pulsefoundry/Aster-MCA-Nano/firmware/at32-burst/README.txt

Aster MCA Nano AT32 — v0.5.0 分段采集测试固件
状态：v0.5.0 已烧入实物，程序/页边界/选项字节读回校验通过。
SMA空载及探头本底均已完成桌面GUI各30秒验证，采集完整性检查通过。
软件检查：7项分段协议/处理/中断测试、17项上位机回归测试通过；
打包后的1M与分段处理库自检通过，JavaScript语法检查通过。

目的
将 4 MS/s 的 ADC/DMA 采样与波形筛选、USB 传输分开，先验证真实波形。
每次命令采 8192 点（2.048 ms，16 KiB），一次性 DMA 不循环覆盖；
完成中断先停止定时器，再记录错误。停止采样后统计并发送完整原始数据。
不在采样期间筛选、压缩或上传波形。USB 控制/SOF 中断仍运行，
因此并不声称采样期间电气上完全没有 USB 活动。

配置
AT32F423CCT7，Flash 256 KiB，SRAM 48 KiB，擦除页 2 KiB。
CPU 144 MHz，内部 LDO 1.3 V，ADC 72 MHz、12 位、2.5 周期采样。
TMR3 每 36 个时钟触发 PA0 ADC1_IN0；DMA1 Channel1 存储8192点。
沿用实物已用的 XTEST=9 后启用/校准流程、USB 48 MHz HICK/ACC路径。
PB12 心跳灯；PA9 保持输入。无硬件改动，无150MHz升频。
DMA完成中断放在 SRAM 执行，减少最后一次转换后的停表延迟。

主机
capture.py 的 --seconds 表示总耗时，并非实际采样覆盖时长。
每段独立验证序号、长度、CRC32、极值、和、平方和、DMA错误、剩余数、
ADC溢出及起停周期数。原始串口字节保存在 wire.bin，便于审计错误帧。
samples.u16 为各段顺序存储；必须按 blocks.jsonl 的边界读取。
段间没有样本，不能把前后段拼成连续波形。
events.csv 用 segment_id、trigger_sample_in_segment 和 time_in_segment_s
标识事件；stored_sample_offset 只用于定位文件，不代表连续时间。

上位机处理
保留已有4M主机算法：256点基线+16点保护区，负脉冲门限默认20码，
64点事件窗，峰高及4/8/16微秒积分。每段完全重置处理状态。
前272点用于基线建立；末59个位置无法提供完整事件后沿。
截断的待处理事件丢弃，计入 boundary_partial_events_excluded。
analysis_window_seconds 只扣这些几何边界，不等于经过死时间修正的活时间。
段内触发保持、堆积与质量筛选仍影响接受率；未能量标定。
分段模式与原1M/4M连续记录使用不同method，GUI禁止直接扣本底。

桌面界面
outputs/Aster Nano.app 同时支持原1M v0.3.1、4M选窗v0.4.4、分段v0.5.0。
分段模式显示总耗时、实际采样覆盖时长和采样占比。
选定的门限仅用于电脑端分析，降低门限不会增加板端数据流量。
停止按钮等待当前完整段收完再停止。错误或中断记录标记无效并禁用导出。

烧录边界
flash.py 默认仅接受当前实物 v0.4.3 的精确二进制匹配。
先备份全Flash和选项字节；只按程序所需页擦写；读回确认程序、页填充、
擦除范围外及选项字节。--restore-1m 仅从精确 v0.5.0 恢复旧v0.3.1。
需要实体BOOT操作；没有应用内自动进入DFU的功能。

首次实测计划
1. SMA断开：INFO确认版本/时钟/ADC初始化，短时多段传输与耗时检查。
2. 检查每段CRC及所有采集错误为0、无段号跳变、原始点数匹配。
3. 检查基线、噪声、异常跳变；USB间隙单独记账。
4. 用户确认接好已开启探头、源移开后，再测真实负脉冲。
只在上述实测通过后更新本文件状态；编译/单元测试不代替实物验证。

2026-10-15 实物空载结果
桌面GUI总耗时30.029601秒，共1081段、8855552点；每段8192点。
实际采样覆盖2.213888秒，采样占比7.372%；其余为USB/主机处理等空档。
CRC/统计/段号/时序检查全部通过，DMA错误、DMA剩余数、ADC溢出均为0。
每段起停耗时295034–295039个144MHz周期，约2.04885ms，含起停开销。
段内标准差中位数1.969 ADC码，范围1.663–2.674码；基线均值2050.016–2051.753码。
20码主机门限下候选0，接受0。只说明该空载短时记录，不能推导能量分辨率。
数据：work/at32-gui-recordings/capture-20261015-001021-516284
首次1秒测试：work/at32-burst-2026-10-14/open-input-first（36段，全部通过）。
桌面应用已实测连接v0.5.0、启动采集、显示采样覆盖/总耗时/采样占比并自动保存。

2026-10-15 探头本底结果
用户确认探头接好并开启，保持原高压/增益，铯源和钍源移开。
GUI总耗时30.030704秒，1081段/8855552点，采样覆盖2.213888秒；占比7.372%。
完整传输及采集检查通过，无DMA/ADC错误。393个完整候选，356个接受。
37个未接受：36个基线未稳定，1个同时标记堆积和过宽/过晚（标记可重叠）。
另有2个段末截断待处理事件排除；段首272点和段末59个触发位置不作为完整事件窗口。
接受事件典型半高宽5–6点（1.25–1.5us），为半高宽而非用户描述的整个脉冲宽度。
接受峰高中位数73.924ADC码；积分中位数118.953 ADC码·us。全记录无0/4095削顶。
已保存波形和本底谱，并在当前桌面会话设为本底。新旧模式不能直接扣本底。
数据：work/at32-gui-recordings/capture-20261015-001338-073683
波形图与统计：本发布文件夹 evidence/probe-background-waveforms.png 及JSON。
后续建议保持设置做铯源对照；7.4%采样占比意味着要增加总测量时间。
截至本检查未做4M分段铯源峰宽测量，不宣称能量分辨率已经改善。
