pulsefoundry/Aster-MCA-Nano/firmware/at32-dma/README.txt

最新状态：v0.2.0 已烧入实物 AT32F423CCT7，并完成采样率与空载验证
更新：2026-10-14T13:55:12.160544+08:00

结论
1 MS/s 定时器触发＋DMA 采样已在实物运行。默认每点间隔 1 us，相比之前 100 kS/s 提高 10 倍。
仍为分段诊断采集，USB 发送期间有间隙，不是连续无死时间 MCA。

烧录证据
- 写入 16180 字节，读回全 Flash 对比成功；末页填充为 FF，擦除范围外保持原样。
- 选项字节前后相同。未改写引导配置。
- SHA256：1ed998aa856a1b4ae0054efbbae88566aaad50e31cf5bf66c41001bb8ce66934。
- 退出 DFU 时工具返回 74；随后同序列号 USB CDC 恢复并返回 v0.2.0，确认应用启动成功。

实物验证
- 10 kS/s、100 kS/s、500 kS/s、1 MS/s 均完成采集和主机独立校验。
- 共 48 段、393216 点，全部 CRC32、极值、总和、平方和一致。
- 所有记录 DMA 错误=0、DMA 剩余数=0、ADC 溢出=0。
- 1 MS/s 每段 8192 点；空载复测起停耗时 393353–393357 个 48 MHz CPU 周期，
  约 8.19485–8.19494 ms。设定采样时长 8.192 ms，差值含转换、开始/完成处理开销。
  这是内部计时的实测佐证，绝对频率尚未使用外部校准时基验证。
- ADC 暂停时拒绝采样；重新初始化后采样正常；不支持的采样率请求被拒绝且原配置保持。
- 软件重启后恢复默认 1 MS/s，USB 恢复，三段原始数据校验通过，ADC 故障码为0。

空载复测（用户明确确认 SMA 完全断开）
- 10 kS/s：8 段，基线约 1.649649 V；标准差 2.296 LSB（约 1.850 mV RMS）。
- 100 kS/s：8 段，基线约 1.649923 V；标准差 2.290 LSB（约 1.845 mV RMS）。
- 1000 kS/s：16 段，基线约 1.650014 V；标准差 2.267 LSB（约 1.826 mV RMS）。

早期异常与限制
刚烧完的第一轮记录有较大的瞬态，不能当成探头脉冲或静态底噪指标。
用户确认 SMA 断开后，ADC ON 重新校准并做32段复测，未再出现相同的大幅异常；
随后软件重启、使用上电初始化路径的三段1 MS/s采样也正常，标准差约2.20–2.25 LSB。
插拔扰动、接触/环境影响与重新校准的作用没有被独立分离，因此不宣称已定位根因。
本轮基线数值只代表这些短记录，不是长期稳定性、ADC本体ENOB或整机能量分辨率。
所有电压按名义3.3 V参考换算，指ADC引脚。输入建立时间、窄脉冲峰值和能谱仍待探头实测。

当前板上状态
v0.2.0，1 MS/s，ADC 开启；无命令时不采样，运行灯心跳继续。
可以接回探头，在新采样率下重新观察负脉冲能否覆盖足够多采样点。

文件
固件 .bin、.elf、manifest.json；source/源码快照；evidence/包含全部烧录、首轮验证、
空载复测、软件重启记录与原始二进制；validation-summary.json为汇总。
以下保留开发阶段记录，其中“等待烧录”状态已经被上面的实物验证更新。

============================================================
Aster MCA Nano AT32 v0.2.0 — 1 MS/s 定时器/DMA 诊断固件
状态：已编译及静态检查；等待用户将实物板进入 BOOT/DFU 后烧录验证。未声称已在实物运行。

变更
- 最高配置从 100 kS/s 软件轮询提高到 1 MS/s 硬件定时触发；每点名义间隔 1 us。
- 保留 10 kS/s、100 kS/s、500 kS/s，支持 RATE 10000/100000/500000/1000000。
- SLOW=10 kS/s；FAST=100 kS/s；TURBO=1 MS/s。上电默认 TURBO。
- 每段 8192 个 12 位 ADC 样本，uint16 小端传输；CPU 在采集完成后统计并发送。
- TMR3 TRGOUT 触发 ADC1_IN0，DMA1 Channel1 经 DMAMUX 从 ADC1 ODT 写入 SRAM。
- 使用一次性 DMA，不循环覆盖；完成中断先停定时器，再记录 DMA 错误、剩余数、ADC 溢出及 DWT 耗时。
- CRC32、样本和、平方和、极值仍由主机独立重算。

时钟与模拟条件
- HICK/ACC、CPU 和 USB 保持已验证的 48 MHz 路径，无外部晶振/PLL 改动。
- ADC 时钟改为 HCLK/2=24 MHz，保留 xtest=9 后启用/校准的厂家勘误修正。
- 1 MS/s：6.5 ADC 周期采样；12 位转换 12.5 周期。
  加上普通组触发延迟 2 ADC 周期和 1 PCLK2 周期，名义合计约 895.8 ns，小于 1 us。
- PA0 属于快速 ADC 通道。设计 R20=100 ohm、C9=1 nF，动态建立时间仍需实测。
- PA0 模拟输入、PB12 低有效运行灯、PA9 输入和 SWD 配置保持。

已做的软件检查
- ARM GCC 14.2 编译通过，无编译告警。
- 固件 16180 字节；按 CCT7 的 256 KiB Flash、2 KiB 页检查边界。
- 链接 SRAM 48 KiB，DMA 缓冲区与预留栈不冲突；DMA 中断向量指向实际处理函数。
- 四档 ADC 转换加触发延迟均小于设定周期。
- 主机拒绝 DMA 错误、未传完、ADC 溢出和整段耗时偏离预期超过 1% 的数据。

烧录和验证
- 用户先断开 SMA，按住 BOOT 重插 USB，约 1 秒后释放。
- flash.py 仅接受唯一的 2E3C:DF11、256 KiB / 2 KiB DFU 设备，先备份 Flash/选项字节。
- 核对旧应用为 v0.1.0 后才写入；读回全 Flash/选项字节，逐字节校验新程序及边界外不变。
- 成功后退出 DFU，再由 verify.py 验证四档采样、CRC、耗时、ADC 暂停/重启和心跳。
- 如 Mac 再次提示配件访问，需要允许。USB 产品名、VID/PID、序列号生成方式沿用 v0.1.0。

范围
这仍是分段诊断采集，USB 传输期间存在采集间隙，不能当作连续无死时间 MCA。
1 MS/s 仍不保证能准确测量亚微秒脉冲；必须先看实测波形能否被足够多采样点覆盖。
当前不支持应用内切换 ROM DFU；后续升级仍需物理 BOOT 操作。

源码及复现
源工程：firmware/at32-dma；同工程 firmware/at32-bringup/read_baseline.py 提供主机传输。
构建脚本依赖本机 ARM GNU 14.2 工具链及 work/at32-bringup-2026-10-14/sdk。
source/ 为源文件快照，不含完整 SDK/工具链，非独立构建目录。
SDK commit a60472b248c39034f111ac17e7b1286549594435。
依据：本地官方 AT32F423 数据手册 Rev 2.03 第68–69页、ES0010 Rev 2.0.5 第8页、厂商定时器/ADC/DMA示例。
