pulsefoundry/Aster-MCA-Nano/firmware/at32-peak-scope/reference/README.txt

Frozen v0.8.1 image retained solely for guarded migration identity checks. Its finite full-buffer RAW diagnostic failed with ADC overflow and is not a recommended firmware. Use the validated v0.8.2 image for the current diagnostic mode.
SHA256: 86ab85df37dd1405018b548fcc33a5acf73e55440f268712b980be2d4259b0cb
