pulsefoundry/Aster-MCA-Nano/docs/2026-10-18-checkpoint.md

# 2026-10-18 检查点

本轮工作已结束，采集停止。用户外出后只进行本机整理、软件检查和 Git 推送；没有继续访问板子、重新烧录或自动采集。

## 需要保留的实物状态

- AT32F423CCT7，AT32 v0.3 PCB。
- 已装 v0.8.2；本次增益改焊没有重新烧固件。
- R21 = 40.2 kΩ，R22 = 10 kΩ，标称运放增益 5.02。用户报告两者串联约 50.2 kΩ，直流节点符合预期。
- 正常采谱门限 100 ADC 码，4 MS/s，2048 道、每道 1 ADC 码。
- 最后确认的探头已开启、接在 SMA，铯源处于此前位置，高压和探头增益保持原设置。这是当时记录，恢复前须重新确认。
- 上位机 v0.6.1 显示改焊后 60 秒铯源谱，叠加改焊后 10 秒本底。重连会回填门限 20，使用当前板子需改回 100。

## 已完成验证

v0.8.2 完整烧录回读、选项字节不变与擦除范围外 Flash 不变检查通过。v0.8.1 的全缓冲 RAW 因 ADC 溢出被否决，v0.8.2 使用半缓冲停止及另一半保护区。

改焊后空载 100 段 RAW + 3 秒谱、探头本底 500 段 RAW + 10 秒谱、铯源 500 段 RAW + 10 秒短测 + 60 秒谱均通过完整性检查，无设备超时或 ADC 溢出。

本底 10.000384 s 接受 898 事件；铯源 10.000384 s 接受 2928 事件；铯源 60.000256 s 接受 17,611 事件。最后一轮 58,594 个 DMA 块全部处理。最晚快照复制结束为 17,220 个 CPU 周期，低于 147,456 周期的覆盖期限。

接探头的安静 16 µs 短窗口噪声约 0.95–0.97 ADC 码 RMS；该统计移除了每窗均值，并有范围筛选，不涵盖全部低频漂移及正常实时处理负载下的噪声。

## 谱与拟合边界

改焊前后各 60 秒谱采用相同整数取峰算法。旧固件为 v0.8.0，新固件为 v0.8.2；门限 20 → 100 近似补偿增益变化，基线质量筛选仍保持固定 ADC 码上限。

| 项目 | 改前 | 改后 |
|---|---:|---:|
| 峰位／ADC 码 | 78.333 | 408.787 |
| FWHM／ADC 码 | 13.471 | 65.695 |
| FWHM／峰位 | 17.197% | 16.071% |

总源谱使用逐道积分高斯加非负线性连续本底，未平滑、未拟合扣本底数据。改后窗口敏感性约 15.36%–16.96%。300 次模型条件下 Poisson 重采样的改后－改前差值 95% 区间为 [−2.50, +0.33] 个百分点，尚未证明显著提升。统计区间不含模型、漂移、源位置复现及模拟／质量筛选系统误差。未作多点能量标定。

当前证据只支持这组配置下的整体表现约 16%，不能直接称为探头本征分辨率。9% 是早前外推值；另一台成品 Aster 曾有约 12% 实测，但不是本轮同步切换的严格对照。

## 后续方向

先确认实体接线和源状态，再决定是否继续。可优先做同一批原始脉冲的采样峰高、峰顶插值、短窗积分对照，并检查漂移与脉冲形状依赖；尚无新的算法改善结论。

原始波形诊断每组 500 × 4096 点仅覆盖 0.512 s，段间存在上传空隙。正式 60 秒谱使用板上连续采样、结束回传的路径，两者时间含义不同。

数据、图和详细验证表见 `outputs/Aster-MCA-Nano-AT32-增益5倍实测-20261018`；改焊位置与料号见 `outputs/Aster-MCA-Nano-AT32-增益改焊-20261018`。
