pulsefoundry/Aster-MCA-Nano/firmware/at32-continuous/README.txt

Aster MCA Nano AT32 连续采样固件 v0.3.1
2026-10-14

目标与当前状态
保持 1 MS/s、12位、PA0输入及现有模拟前端；连续DMA，电脑端处理脉冲和能谱。
新固件已烧入并回读校验；通过空载1秒、60秒连续采集及故意停止读取后的保护/恢复测试。
60秒采集完整保存60,000,256点，所有块校验通过，未报告DMA/ADC/处理超时错误。
探头本底和铯源对照尚待进行；目前只完成空载连续采集验证。

硬件采集
CPU 96 MHz、ADC HCLK/4=24 MHz、采样6.5周期、TMR3每96周期触发，保留XTEST=9。
ADC DMA环4096点，每半2048点，半块间隔2.048 ms。
DMA/USB解耦；6个压缩包缓冲；正常采样期间没有停定时器上传的间隙。
采集到完整半块后压缩，另半块继续采样。压缩前后检测覆盖风险和DMA错误。
缓冲区满、来不及处理、ADC溢出、DMA错误等会停止并报告失败，不静默丢样。
主机停止或定时结束在完整半块边界执行；边界后的少量尾样本单独报告并排除。

无损传输
每个块预测器从0开始。按低半字节先行编码：0..14表示差分-7..+7；
15表示后续三个半字节给出绝对12位样本。最后一个未用高半字节为0。
没有触发筛选、抽点、截位或板上幅度计算，全部样本发送到电脑。
历史空载和放源数据约0.54–0.56 MB/s（含头部），最坏输入仍可能超过USB能力。
缓冲区只能吸收短时抖动，不保证任意高熵波形均能持续无损传输。

协议
ASCII命令（仅空闲时响应）：INFO、PING、STREAM 毫秒、ADC OFF、ADC ON、REBOOT、HELP。
STREAM 0持续运行直到STOP；定时STREAM支持1–3600000 ms，时长向上取整到2048点。
开始响应OK STREAM后仅发送二进制包；采样中仅处理STOP，不混入ASCII应答。
80字节头：8字节ASTC03\r\n + 18个小端uint32：
版本、类型、会话、块序号、首样本位置低/高、样本数、采样率、载荷长度、编码、
解码样本哈希、载荷哈希、错误标志、已完成DMA块数、DMA中断DWT周期、
编码周期、经过毫秒、头部哈希。
类型1为2048点压缩数据；类型2为JSON终止记录。哈希用于传输完整性检查而非安全认证。
载荷/头部用字节FNV-1a；样本用uint16值逐次xor/multiply的32位FNV变体。
如果80+载荷字节数是64倍数，则附加一个0字节，使USB传输以短包结束。
主机拒绝校验失败、错序、重复、样本位置不连续、会话改变及错误终止的记录。
出现异常时标记整轮无效，发送STOP并保存后续诊断字节，再读取空闲状态。
异常字节不重新拼接成有效能谱；电脑暂停读取3秒的实测触发了板端缓冲满及USB超时。

上位机
capture.py保存stream.astc、完整解压samples.u16、blocks.jsonl、events.csv、
spectrum.csv、capture.json、spectrum-summary.json。
全部解压和脉冲处理在Mac本地执行。首次运行由cc编译本地辅助库。
固定基线来自触发前64点，预留4点间隔；负脉冲门限默认20码。
有符号积分窗口4/8/16 us，从触发前一个点开始；所有状态跨DMA/USB边界保持。
事件标记位：1基线不稳，2可分辨堆积，4采样削顶，8过长/过晚，16未恢复。
能量估计保存为原始采样峰高和积分面积，不应用keV标定。
两个4096道直方图：peak=峰高码值取整；area8=8us面积码·us除4后取整。
直方图越界独立计数，不回卷也不伪造满量程道计数。
末尾未完成事件单独排除；触发保持时间及筛选会影响接受率。
1 MS/s仍可能低估窄脉冲峰高；当前不能声称能量分辨率或无堆积。

例：在当前工程根目录运行
python3 firmware/at32-continuous/capture.py \
  --port /dev/cu.usbmodem13819F0C28761 --seconds 30 \
  --input '探头已开启，源已移开；记录实际增益/高压/接线' \
  --out work/at32-continuous-2026-10-14/background-unique-name

构建与检查
python3 firmware/at32-continuous/build.py
python3 firmware/at32-continuous/test_host.py
flash.py仅接受当前已烧入v0.3.0旧固件及256KiB/2KiB页DFU设备。
烧录前备份全Flash和选项字节，写入后校验全Flash及擦除范围外不变。
板上BOOT操作由用户完成；不修改选项字节，不做全片擦除。

输入状态必须随每轮记录
空载、探头关闭、探头开启本底、铯源在位不可混淆。
先固定探头高压/增益/接线和源几何，采背景，再由用户确认放源后采源组。
比较时使用采样覆盖时长归一化，并同时查看筛选、削顶和错误计数。
原始数据与上位机参数保留，以便对同一批脉冲重做算法比较。

修订v0.3.1：v0.3.0实板在48MHz下编码耗时达到约96660周期/半块，触发处理超时保护；该版不能作为有效连续采集版本。优化双样本快速编码并将CPU调至96MHz，保持ADC24MHz和1MS/s。60秒空载实测最大编码38672周期，约0.403ms，发送队列最多占1/6。

空载模拟表现：60秒数据的全记录标准差约3.05mV RMS（按3.3V标称换算）；范围2029–2081码。
默认20码触发门限下出现1536个候选，全部因过长/未恢复而排除，入谱0个。
这不证明模拟噪声消失或对探头无影响。保持原始样本，以探头数据继续验证和调整电脑端算法。
