pulsefoundry/Aster-MCA-Nano/firmware/at32-eventstream/README.txt

Aster MCA Nano AT32 v0.7.1 — 0.5 MB/s 原始波形传输优化候选版
状态：v0.7.1空载30秒吞吐通过，但真实探头事件传输在约54 ms处理超时，不能用于正式采集。用户已决定停止此路线，准备回退v0.6.3。

模式
BENCH <毫秒> <门限>：ADC持续4 MS/s运行并逐块检查，每两个4096点DMA块传前一个块的前512点。
有效原始波形速率为500000 B/s（按标称采样时钟），含帧头/校验约533203 B/s。
这只是带真实ADC负载的固定速率测试；电脑只收到6.25%的采样点，不能作为完整脉冲采集。
STREAM <毫秒> <门限>：连续ADC/DMA，负向触发，传每个候选的512点原始波形。
包含触发前320点（80us）、触发起192点（48us）；触发保持时间64点（16us）。
基线256点、保护16点，门限默认20 ADC码；在电脑端保留基线、脉冲和尾部以便重新整形。
没有板上能量积分、质量筛选或直方图，不能把触发数等同有效谱计数。
每个事件1024字节波形+68字节元数据/校验，约498触发/s时有效0.510 MB/s，总帧0.544 MB/s。
触发稀少时传输量会降低，不用补充虚假事件来凑速率；高计数率可能超过能力。
最长600秒，避免32位绝对采样位置溢出；不可连接窗口之间的空缺。

完整性
独立4096点快照沿用v0.6.3，复制截止时间1.024ms；DMA/ADC/中断/复制超时自动停机。
8帧队列，整帧异步USB传输，数据缓冲在传输完成前不复用；队列满或USB超时停机，禁止静默丢包。
64字节包头、1024字节原始ADC数据、4字节校验尾；短包结尾，顺序和校验均验证。
接收端额外核对触发与所传基线是否一致、重叠波形逐点一致以及结束时计数守恒。
保存wire.bin、windows.u16、windows.jsonl、capture.json；失败记录保留为诊断，不生成有效谱。
已知边界：启动320点不触发；结束不足192点后沿的候选单独记账；保持时间内再次跨门限计数单独报告。
通过数据完整性检查不等于无触发死时间，不等于已标定能谱。

配置
AT32F423CCT7；CPU144MHz，内部LDO1.3V，ADC72MHz/12bit，采样4MS/s；硬件/引脚/时钟均沿用已验证配置。
不改动原v0.6.3固件源码与已保存谱。新固件不兼容旧桌面GUI，只使用本目录接收端验证。
固件内置复制、SIMD、触发自检；故障时拒绝采集。

上板步骤
先断开SMA并用实体BOOT进入DFU，运行本目录flash.py：精确匹配已冻结的v0.7.0、备份全Flash及选项字节，写入后完整读回验证。
先INFO/自检；空载BENCH 3秒再30秒，核对有效吞吐、队列余量及ADC完整性。
空载STREAM检查异常触发；用户重新确认探头及源状态后，测试真实事件传输。
只有实测后才能标记0.5 MB/s成功。若需回退，实体BOOT后flash.py --restore-histogram。

命令示例（端口须重新核对）
python3 firmware/at32-eventstream/capture.py --port <端口> --out <新目录> --seconds 3 --mode bench --condition 'SMA断开'
python3 -m unittest discover -s firmware/at32-eventstream -p test_eventstream.py -v

v0.7.1变化：把事件窗口复制、FNV校验、帧头写入和发送队列管理放到SRAM运行；复用互不重叠的回复/终端缓冲，减少RAM消耗。
门限20、512点窗口、4 MS/s、144 MHz、8帧队列与停止保护保持不变。新增上电4脉冲/1.024ms真实打包自检，含循环复制与校验，USB中断负载仍需上板验证。
ARM汇编已检查：打包热路径均在SRAM，没有对Flash中的memcpy调用。二进制23456字节，静态RAM42816字节，预留4096字节栈后另有2240字节余量。
软件测试包含与独立Python实现逐字节对照的帧编码，以及端到端分片接收测试；均不替代MCU时序实测。
