pulsefoundry/Aster-MCA-Nano/firmware/at32-histogram/README.txt

Aster MCA Nano AT32 — 板上2048道 v0.6.3
状态：2026-10-16已烧录，读回、自检、3秒空载及30秒探头本底均通过。
探头本底：采样30.000128s，含回传校验30.015168s，覆盖99.950%；通过筛选5461、谱内5460、低端量程外1。
最忙计算243001周期（1.687507ms），复制最晚104389周期（0.724924ms），期限147456周期；无ADC/DMA错误。
仅验证这一轮30秒本底；放源负载、长时间稳定性、能量标定与死时间校正仍待验证。
12项算法/通信测试、19项GUI回归测试通过。

v0.6.2在接探头2.109秒后发生复制超时。其编译产物调用Flash里的nano-libc memcpy，8KiB复制约50764周期。
v0.6.3保留独立4096点快照和全部覆盖/积压/计数检查，改用SRAM中的LDM/STM整块复制。
已检查汇编产物：snapshot_copy位于RAM，不调用memcpy；实测空载复制最慢8589周期（0.05965ms），整段最慢58268周期（0.40464ms）。
上电在两个DMA半区以多种数据模式逐点比较复制结果，并检查目标前后保护字；失败设置bist_fault位8。
新增INFO.copy_bist_cycles报告复制自检最大周期数。
积分、脉冲筛选、门限20、2048道映射及4MS/s采样全部保持一致。
CPU144MHz、ADC72MHz、LDO1.3V不变。静态RAM39944字节，余9208字节，包含4KiB栈预留。

烧录：用户实体BOOT后运行python3 firmware/at32-histogram/flash.py。
工具只接受精确冻结v0.6.2旧镜像；完整备份Flash/选项字节，并核对新镜像、擦除填充、范围外Flash及选项字节。
硬件验收：读回、自检、空载、探头本底；复制截止时间、DMA/ADC错误、样本数和所有CRC必须通过。
主机接收端及GUI源已支持v0.6.3；原生桌面包尚未更新，原有启动问题仍待排查。
最终只保存谱，无原始波形；无能量标定或脉冲死时间校正。
