pulsefoundry/Aster-MCA-Nano/firmware/at32-peak/README.txt

Aster MCA Nano AT32 v0.8.0：4 MS/s、2048道、基线扣除采样取峰

以稳定v0.6.3为基线，保留ADC/时钟/LDO、DMA、4096点快照与覆盖检查、触发门限及五类质量筛选。
事件能量从8us有符号积分改为冻结基线减去采样最低值；每道1ADC码，幅度范围0..2048码，负值/超量程单独统计。
沿用64点事件观察窗与原堆积/恢复判定，不增加逐点扫描、不增加第二份谱数组。
采集期间仍不上传波形，到时停止并回传2048个uint32计数；没有保存逐事件波形，不能在事后对本模式记录重做脉冲成形。

构建：python3 firmware/at32-peak/build.py
板上BIST改为检查已知248码峰高的三次注入，复制、min/max与时钟/ADC自检保留。
软件验证：15项引擎/通信测试、20项GUI回归测试通过；原铯源与本底波形逐道峰高谱回放一致。
固件22268字节，SHA256 ee37ef635d930970c4adfa98aed163af5000cf1a0177ab363587051e8fd888ac。
静态RAM39920字节，余9232字节，包含4096字节栈预留。热点函数仍位于SRAM。

烧录：实体BOOT且SMA断开后，python3 firmware/at32-peak/flash.py
仅接受与冻结稳定v0.6.3完全一致的旧程序；先备份完整256KiB Flash及512字节选项区，按页有限擦写并检查新程序、填充、范围外Flash与选项区。
回退：实体BOOT且SMA断开后，python3 firmware/at32-peak/flash.py --restore-histogram
回退仅接受当前程序与本v0.8.0构建逐字节一致，不猜测覆盖未知固件。

2026-10-18已烧录，读回/范围外Flash/选项区检查全部通过。USB应用重新枚举，INFO确认v0.8.0，上电自检零故障。
3秒空载：12001280点，2930个DMA块全部处理；零误触发、零ADC溢出、零设备错误，谱及元数据CRC通过。
30秒探头本底：120000512点，29297个DMA块全部处理；候选2882、接受2566、拒绝316、负值0、超量程0。
本底最慢处理114127周期(0.79255ms)，快照最晚复制结束8859周期(0.06152ms)，ADC/处理错误0。
60秒铯源通过：全部58594个DMA块有效，候选17990、接受15896、拒绝2094，ADC溢出/设备错误/量程外事件均0。
最慢处理156519周期(1.08694ms)，复制最晚17931周期(0.12452ms)。偶发处理超过一个DMA半周期由独立快照承接，所有块处理完且无积压错误；不据此保证任意脉冲负载或长时稳定性。
峰位78.33道、FWHM13.47道，表观FWHM/峰位17.20%；拟合窗敏感性约16.60%..19.23%，当前按17%..19%估计，未能量刻度。
峰高按名义3.3V ADC满量程换算约63.1mV；后续优先核实模拟输入幅度与增益，不把该结果和不同条件历史谱直接当作改善比较。
完整原始谱、CRC/时序与拟合结果见outputs/Aster-MCA-Nano-AT32-取峰-v0.8.0-20261018。

桌面软件outputs/Aster Nano.app已更新为v0.6.0，支持旧积分和新取峰记录，量程与导出单位分别保存；旧软件备份在work/at32-peak-2026-10-18。
本版本不改板、不加峰值保持电路、不启用插值或新基线门控。能量标定及新采集的谱峰宽仍需独立评估。
