pulsefoundry/Aster-MCA-Nano/firmware/at32-continuous/GUI使用说明.txt

Aster Nano GUI v0.1 — macOS 本机上位机
2026-10-14

启动
在 Finder 中双击工程根目录的“启动 Aster Nano.command”。
界面在本机 http://127.0.0.1:8775 打开，不需要网络或云端服务。
本机程序运行期间保留启动窗口；再次双击会打开已有实例。
已验证的目标是当前 Apple Silicon Mac + AT32 连续固件 v0.3.1；没有更改板上固件。
Python 使用标准库；脉冲处理的小型本地库使用现有系统编译器构建，安装包附带本机已构建的库。

基本操作
1. 默认打开此前已保存的铯源谱，并叠加探头本底；顶部“历史记录”与“采集中”明确区分。
2. 点“连接”确认设备版本，再选择输入状态和采集时长；需要时填写高压/增益等备注。
3. 点“开始采集”后实时画谱；“停止”会在完整数据块边界结束并校验。
4. 采集期间不允许打开另一条记录或更改门限；可以改变显示道数、谱类型和坐标。
5. 只有结束并通过连续性校验的记录才能导出。遇到校验、丢块或设备故障，整轮显示无效。
6. 原始波形、传输流、事件表、能谱及状态自动存入 work/at32-gui-recordings/独立时间目录。
7. “导出 CSV”“保存谱图 PNG”直接保存到当前记录的 exports 目录，并显示绝对路径。
   每份导出旁边有同名 JSON，记录映射、门限、时长、源状态和本底来源。

道数定义
默认1024道，支持512、1024、2048、4096道；道号从0开始。
所有显示档位使用固定量程，改变道数只改变分箱宽度，不移动物理量程。
峰高：量程0≤峰高<4096 ADC码。1024道时每道4 ADC码。
8us积分：量程0≤面积<2048 ADC码·us。1024道时每道2 ADC码·us。
积分道号=floor(8us面积×道数/2048)。峰高道号=floor(峰高×道数/4096)。
内部使用4096个主分箱，较低道数对相邻分箱求和。历史数据从逐事件表重新分箱，不插值旧直方图。
负积分及量程外事件独立计数，不压进第0道或末道。“通过筛选”与“当前谱入谱数”因此可能不同。
道数不代表实际能量分辨率；界面当前不提供keV标定或核素自动识别。

显示与本底
默认8us有符号积分谱；可以切换采样峰高谱、计数/计数率和对数纵轴。
拖动图中的横向区间放大，双击或“全谱”恢复；“适合数据”缩到非零数据的范围。
打开一条本底记录后点“设为本底”，再打开待比较谱。
本底按两组采样覆盖时长比例归一。参数不兼容时禁用叠加及扣本底。
净谱保留负道数，扣本底时使用线性纵轴；对数图不绘制零计数道。
导出CSV同时包含原始计数、归一化本底、净计数及计数统计误差，无论当前是否显示叠加。
计数率使用采样覆盖时长，尚未做触发保持/堆积/筛选损失修正，不等同于精确MCA活时间率。

已完成验证
12项自动检查：原有无损协议/跨块脉冲处理检查，以及分箱边界、计数守恒、有效历史载入、
导出计数、错误记录禁用、HTTP本机来源隔离、模拟设备提前停止等检查。
实板GUI提前停止：7.872512秒、7,872,512点完整通过，停止原因user_stop，ADC/固件错误0。
实板GUI定时结束：2.000896秒、2,000,896点完整通过，停止原因duration，ADC/固件错误0。
这两次只做GUI功能验证，输入状态未重新核对，不作为新的本底或放源定量对照。
原铯源记录1024道积分CSV：1024行、入谱22,029个，另34个负积分排除，与事件表相符。
CSV和PNG已通过真实界面保存到磁盘并核对。

保存和退出
完整ADC约120MB/分钟，加传输流约32MB/分钟及少量事件/记录文件。
关闭网页不会停止已经开始的定时采集；需要提前结束时点击“停止”。
退出本机程序可在启动窗口按Ctrl+C，程序会请求停止采集并收尾。
当前仅对macOS本机串口进行了实测；Windows/Linux支持尚未实现。

下一步：从幅度谱到可靠能谱
先固定基线、积分窗口和回摆处理，比较相同原始数据中4/8/16us估计的峰位、峰宽与接受率。
再对候选光电峰选ROI并拟合峰位/FWHM，保存拟合区间、本底模型和误差；不以视觉最高一格代替峰位。
能量刻度用E=a×道号+b，至少两个独立约束，并用另一已知峰检查线性；只有铯峰时只能先做带假设的临时刻度。
固定高压/增益后重复采集、移源回测，再改变计数率，检查峰位漂移、堆积与削顶。
当前约99.9%的脉冲半高宽只有1–2点；若算法优化后分辨率仍受采样相位影响，再评估延长模拟脉宽或提高采样率。
若目标只是可重复的核素谱形比较，以上先做；活度/定量测量还需要效率、几何和死时间校准。

参考
IAEA 能量刻度与线性检查：https://www-pub.iaea.org/MTCD/Publications/PDF/te_564_web.pdf
IAEA Gamma-ray spectrometry basics：https://analytical-reference-materials.iaea.org/almera-webinars
