pulsefoundry/Aster-MCA-Nano/outputs/Aster-MCA-Nano-AT32-v0.3-USB-A-LED/pcb-bottom.png

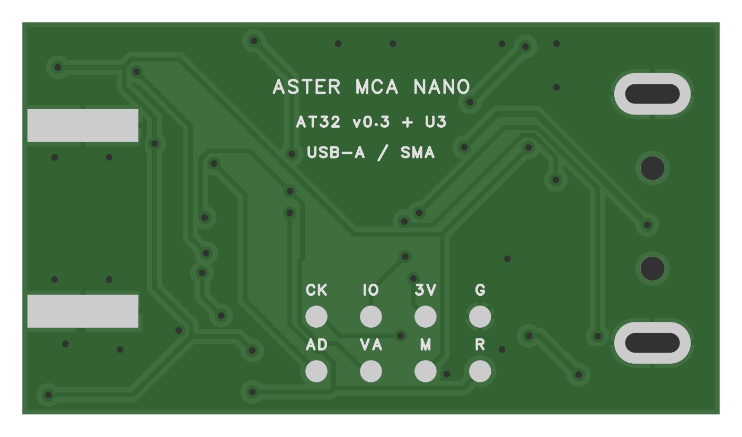
outputs/Aster-MCA-Nano-AT32-v0.3-USB-A-LED/pcb-bottom.png
