pulsefoundry/Aster-MCA-Nano/outputs/Aster-MCA-Nano-AT32-v0.3-焊接对照/AT32-v0.3-焊接位置图.png

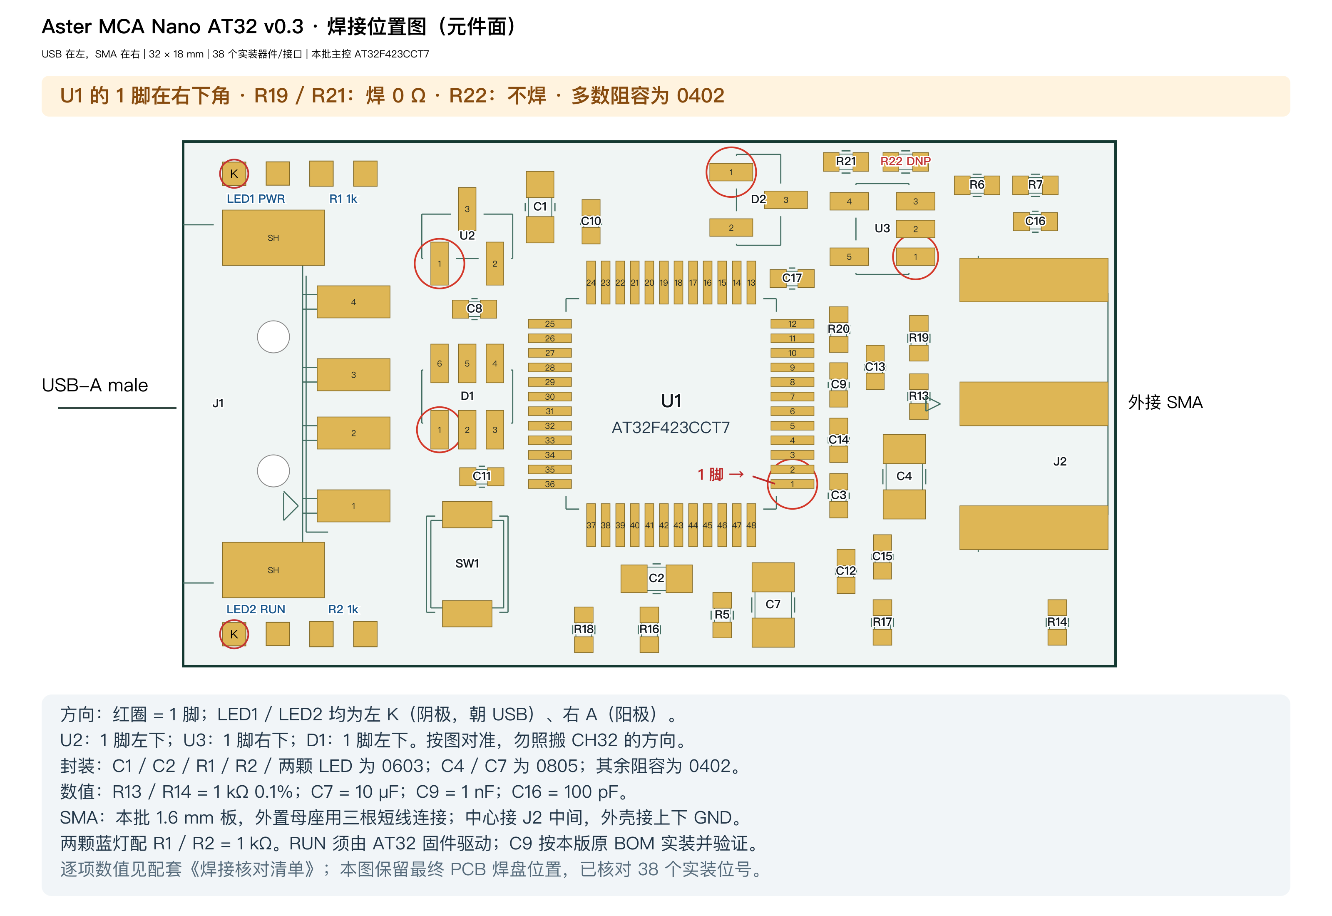
outputs/Aster-MCA-Nano-AT32-v0.3-焊接对照/AT32-v0.3-焊接位置图.png
