pulsefoundry/Aster-MCA-Nano/outputs/Aster-MCA-Nano-AT32-v0.6.3-铯源10分钟分辨率-20261016/铯源谱与分辨率拟合.png

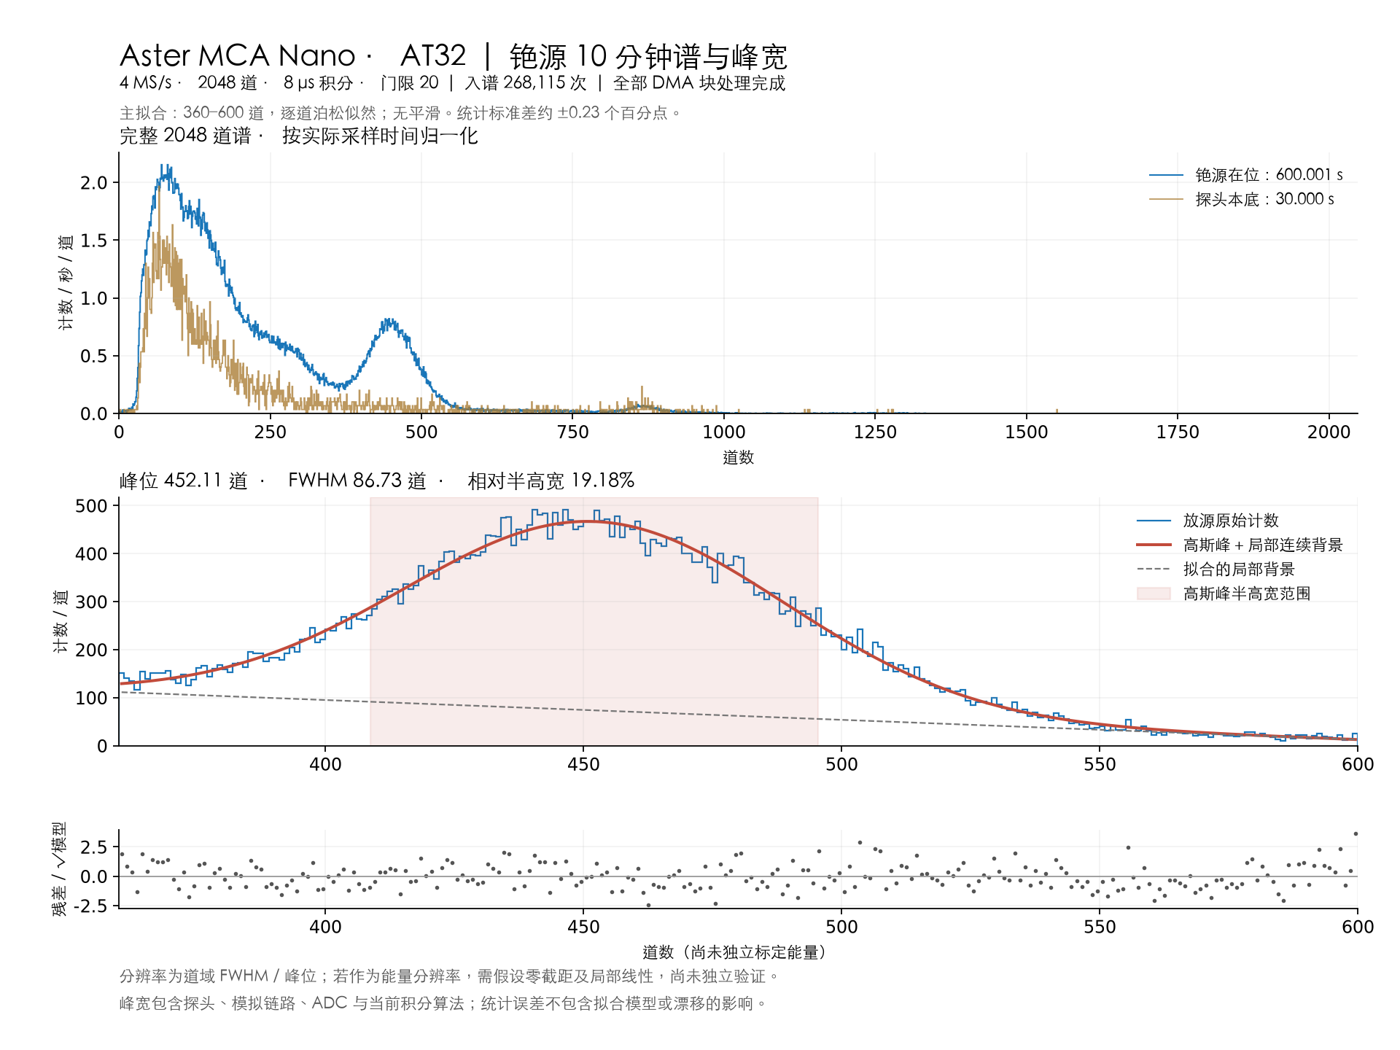
outputs/Aster-MCA-Nano-AT32-v0.6.3-铯源10分钟分辨率-20261016/铯源谱与分辨率拟合.png
