pulsefoundry/Aster-MCA-Nano/outputs/Aster-MCA-Nano-AT32-取峰-v0.8.0-20261018/cs-source-60s-fit.png

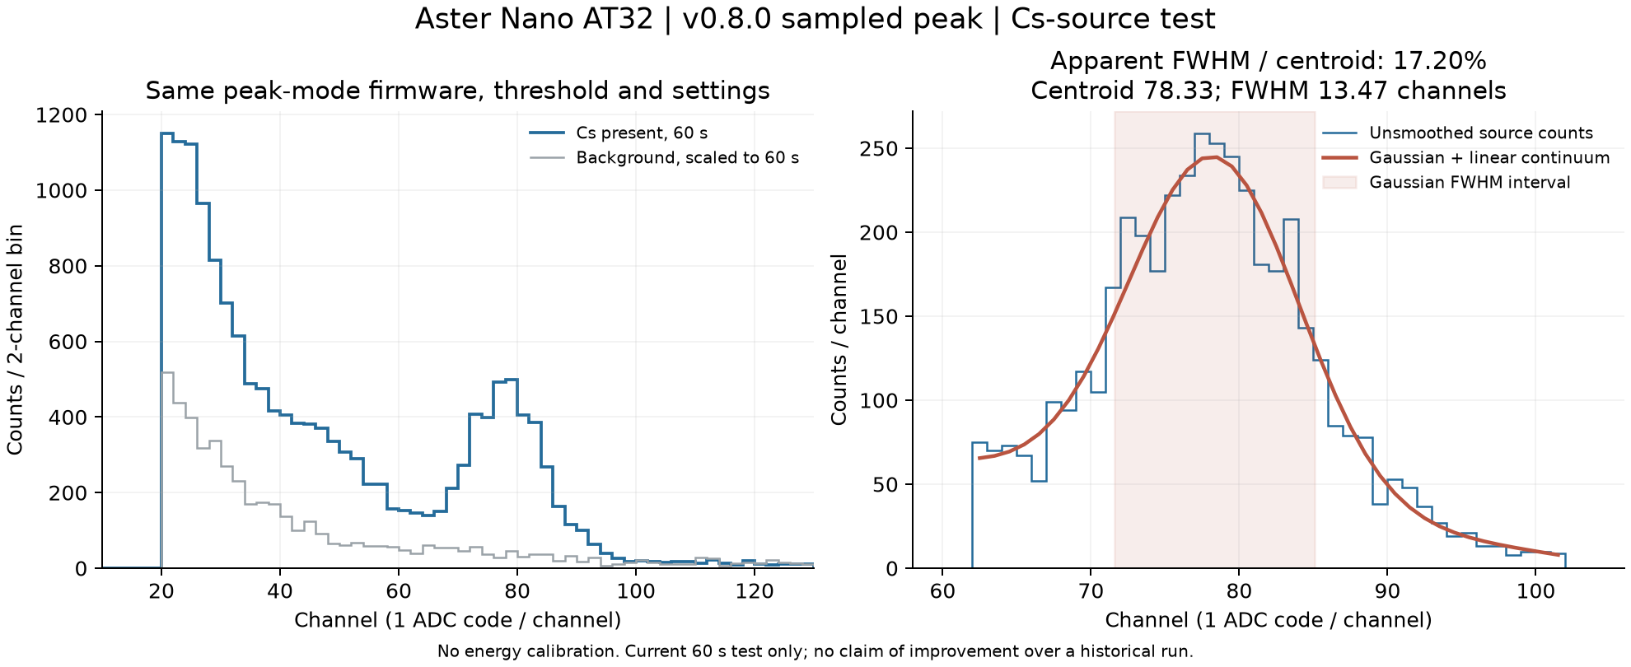
outputs/Aster-MCA-Nano-AT32-取峰-v0.8.0-20261018/cs-source-60s-fit.png
