pulsefoundry/Aster-MCA-Nano/outputs/Aster-MCA-Nano-AT32-增益5倍实测-20261018/analysis-background/waveform-diagnostics.png

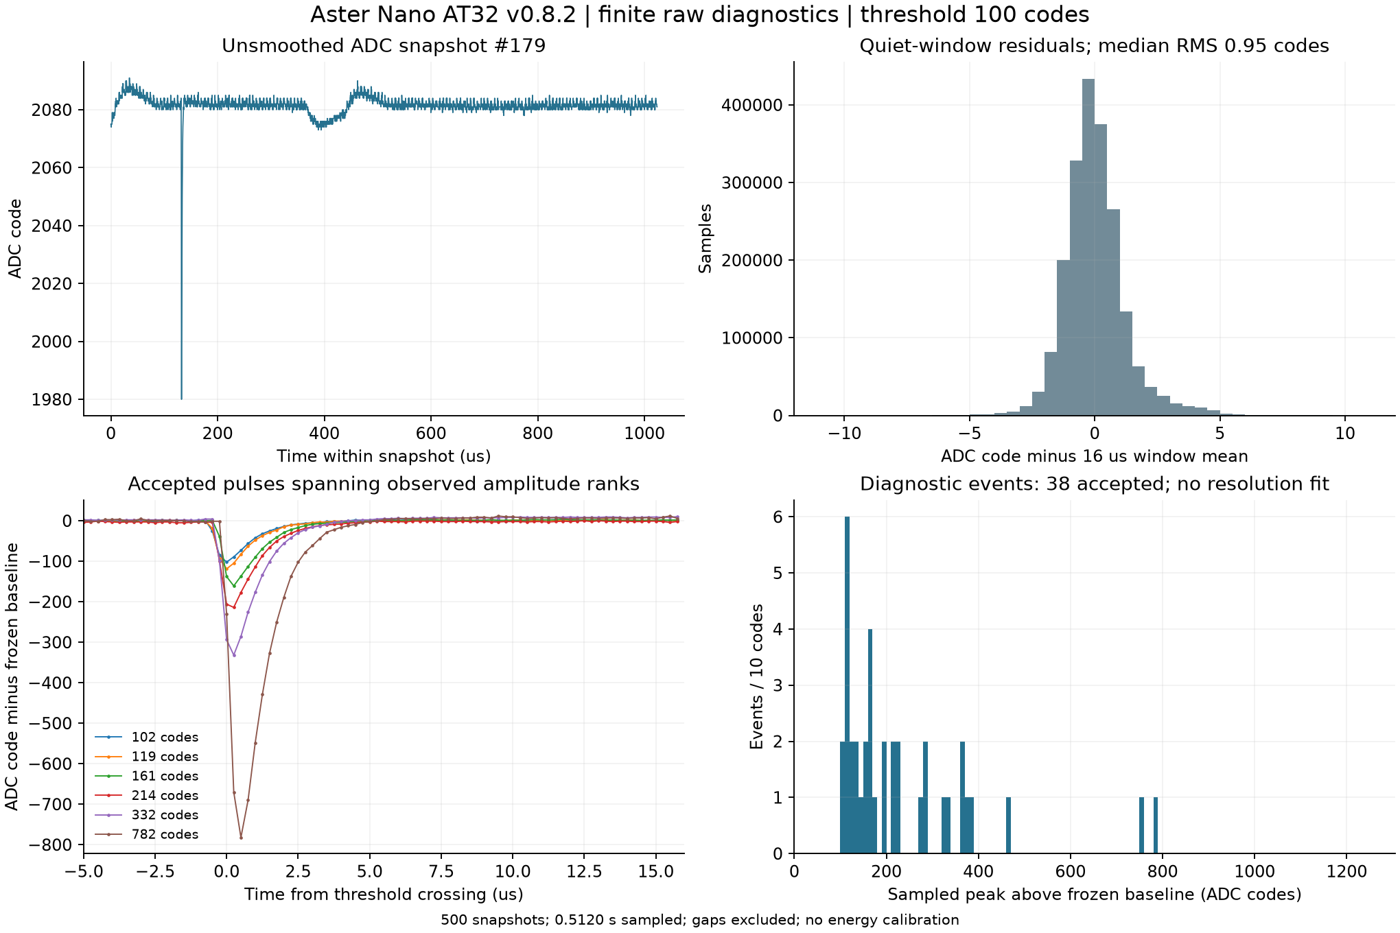
outputs/Aster-MCA-Nano-AT32-增益5倍实测-20261018/analysis-background/waveform-diagnostics.png
