pulsefoundry/Aster-MCA-Nano/outputs/Aster-MCA-Nano-AT32-增益改焊-20261018/AT32-R21-R22-改焊位置.png

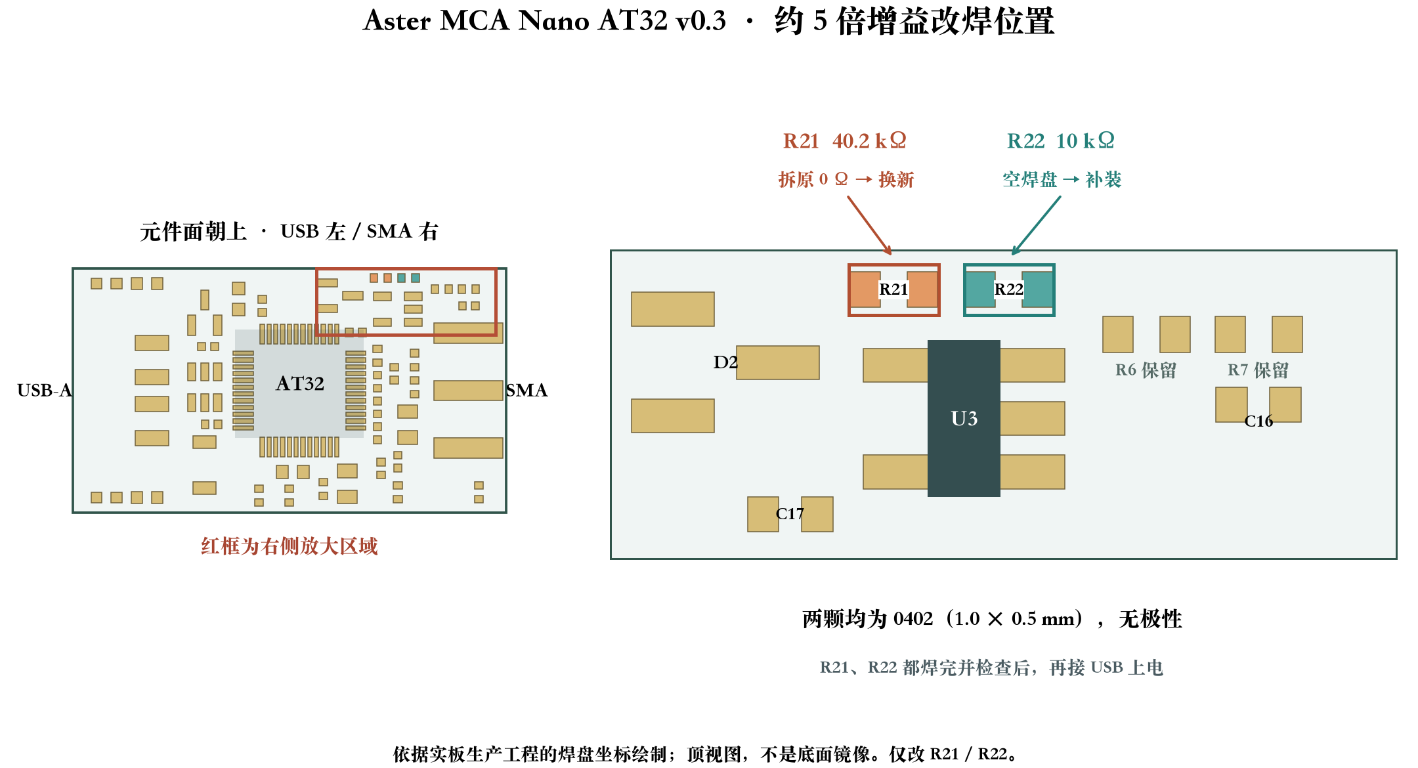
outputs/Aster-MCA-Nano-AT32-增益改焊-20261018/AT32-R21-R22-改焊位置.png
