pulsefoundry/Aster-MCA-Nano/outputs/Aster-MCA-Nano-AT32-波形诊断-v0.8.2-20261018/analysis-Cs-present/waveform-diagnostics.png

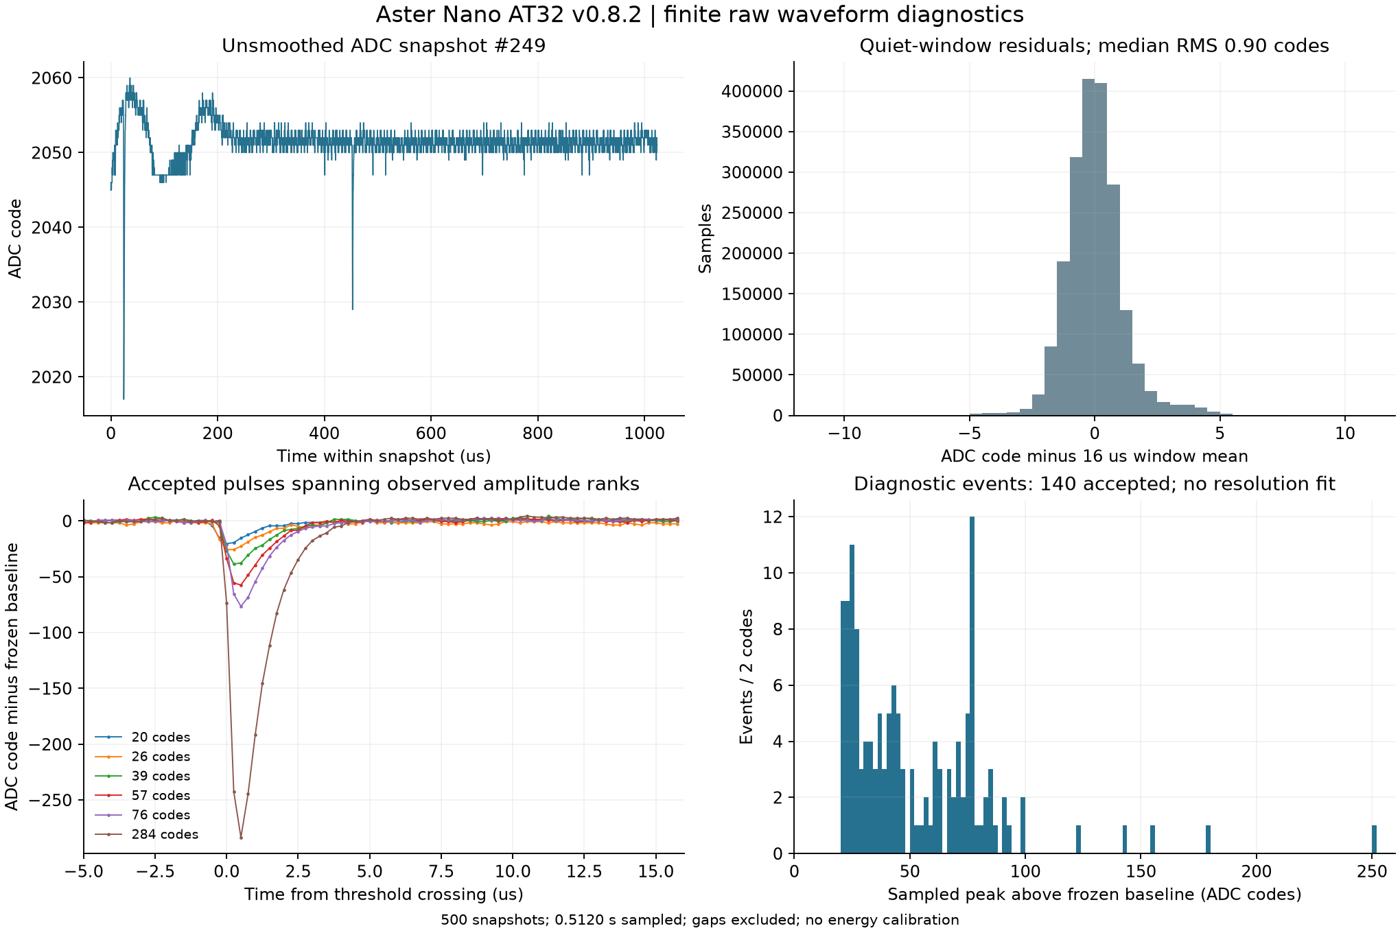
outputs/Aster-MCA-Nano-AT32-波形诊断-v0.8.2-20261018/analysis-Cs-present/waveform-diagnostics.png
