pulsefoundry/Aster-MCA-Nano/outputs/Aster-MCA-Nano-AT32-波形诊断-v0.8.2-20261018/probe-cs-waveform-and-spectrum.png

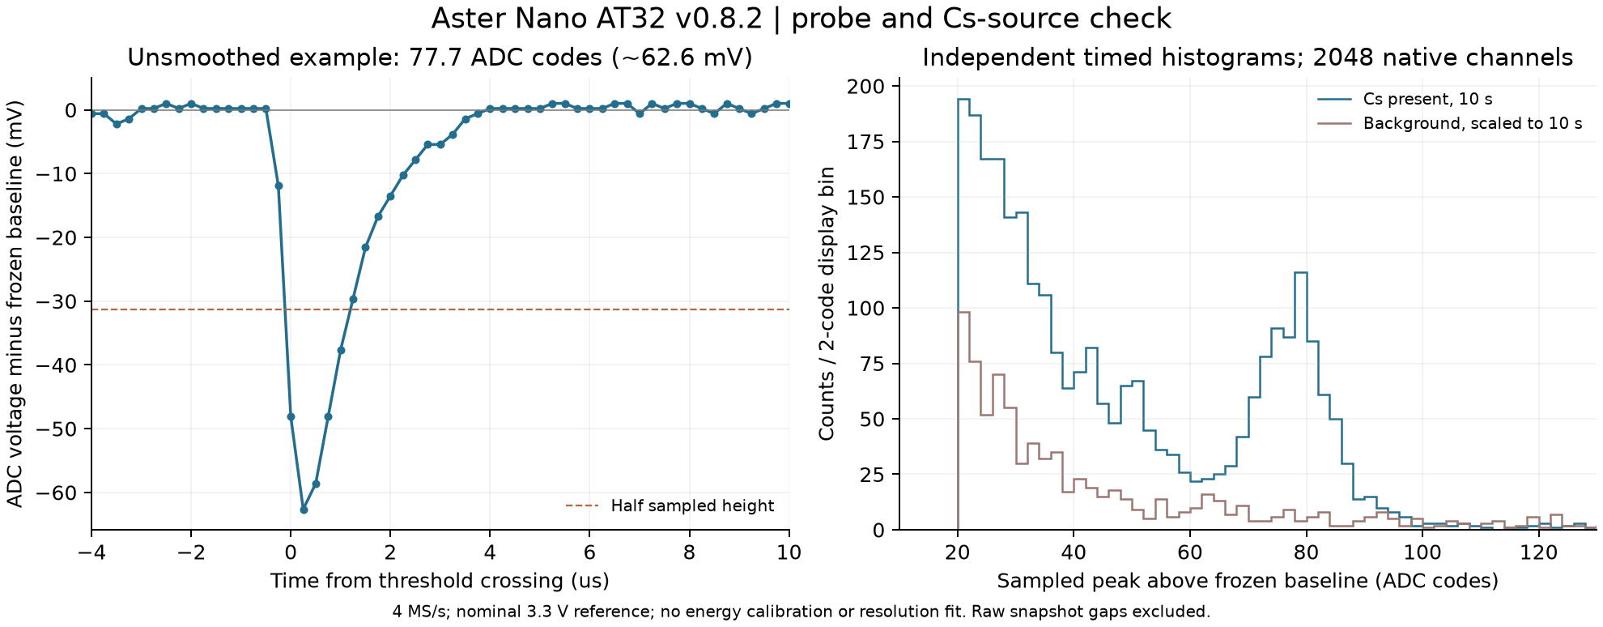
outputs/Aster-MCA-Nano-AT32-波形诊断-v0.8.2-20261018/probe-cs-waveform-and-spectrum.png
