pulsefoundry/Aster-MCA-Nano/outputs/Aster-MCA-Nano-v0.3.1-SlotCut-Bridge2p5-32x38/pcb-bottom.png

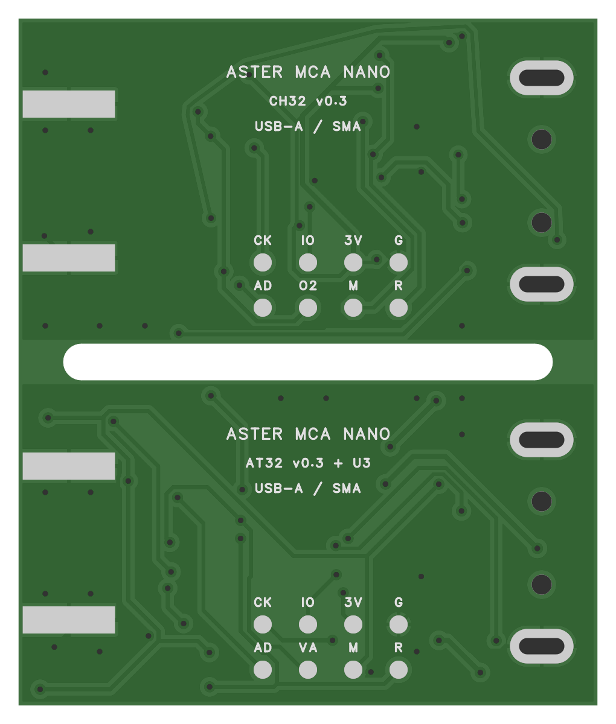
outputs/Aster-MCA-Nano-v0.3.1-SlotCut-Bridge2p5-32x38/pcb-bottom.png
