pulsefoundry/Aster-MCA-Nano/outputs/Aster-MCA-Nano-v0.3.1-SlotCut-Bridge2p5-32x38/pcb-top.png

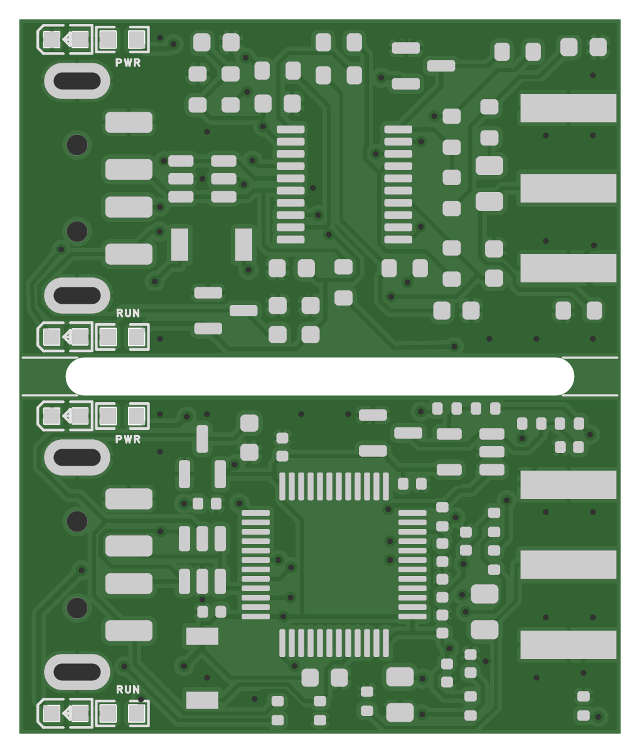
outputs/Aster-MCA-Nano-v0.3.1-SlotCut-Bridge2p5-32x38/pcb-top.png
