pulsefoundry/Aster-MCA-Nano/outputs/Aster-MCA-Nano-取峰对齐离线研究-20261018/nano-peak-alignment.png

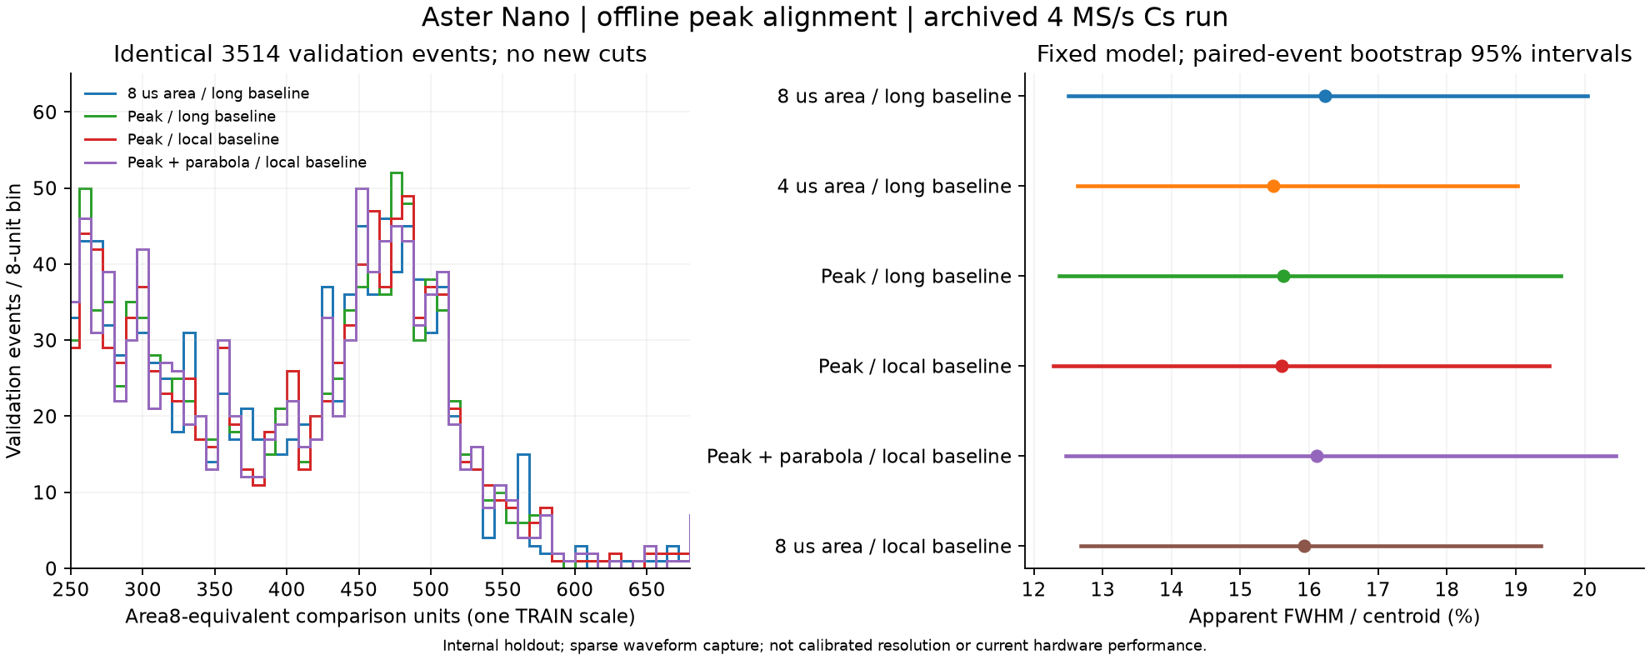
outputs/Aster-MCA-Nano-取峰对齐离线研究-20261018/nano-peak-alignment.png
