pulsefoundry/Aster-MCA-Nano/outputs/Aster-MCA-Nano-v0.3-采购清单/Aster-MCA-Nano-5套-合并采购清单.csv

序号 | 类别 | 型号/规格 | 封装 | 立创料号 | 5套实用量 | 已有库存抵扣量 | 建议购买量(含备件) | 厂家型号 | CH32位号(单板) | AT32位号(单板) | 采购备注 | 料号来源URL
1 | 芯片、保护与连接件 | CH32X033F8P6 | TSSOP-20；4.4×6.5mm；间距0.65mm | C19268290 | 5 | 0 | 6 | CH32X033F8P6 | U1 |  | WCH；5套=CH32版5块+AT32版5块；建议购买量含备件，未按商家起订量取整。 | https://www.lcsc.com/product-detail/C19268290.html
2 | 芯片、保护与连接件 | AT32F423CBT7 | LQFP-48；7×7mm；间距0.5mm | C6705024 | 5 | 0 | 6 | AT32F423CBT7 |  | U1 | Artery雅特力；LQFP48。 | https://www.lcsc.com/product-detail/C6705024.html
3 | 芯片、保护与连接件 | TLV9061IDBVR | SOT-23-5 | C398358 | 5 | 0 | 6 | TLV9061IDBVR |  | U3 | TI；DBV/SOT-23-5，不是SC70或6脚关断版。 | https://www.lcsc.com/product-detail/C398358.html
4 | 芯片、保护与连接件 | XC6206P332MR-G | SOT-23 | C5446 | 10 | 0 | 12 | XC6206P332MR-G | U2 | U2 | Torex；3.3V；核对SOT-23引脚，不按丝印购买替代件。 | https://www.lcsc.com/product-detail/C5446.html
5 | 芯片、保护与连接件 | USBLC6-2SC6 | SOT-23-6 | C7519 | 10 | 0 | 12 | USBLC6-2SC6 | D1 | D1 | ST；USB静电保护。 | https://www.lcsc.com/product-detail/C7519.html
6 | 芯片、保护与连接件 | BAT54S | SOT-23 | C503463 | 10 | 0 | 12 | BAT54S,235 | D2 | D2 | Nexperia；串联双肖特基；235为订购后缀。 | https://www.lcsc.com/product-detail/C503463.html
7 | 芯片、保护与连接件 | B3U-1000P BOOT | B3U-1000P贴片封装 | C231329 | 10 | 0 | 12 | B3U-1000P | SW1 | SW1 | Omron；BOOT按键，须匹配B3U-1000P封装。 | https://www.lcsc.com/product-detail/C231329.html
8 | 芯片、保护与连接件 | USB-A公头；1001-011-01101 | USB-A公头；卧式 |  | 10 | 0 | 12 | 1001-011-01101 | J1 | J1 | CnC Tech参考型号；替代件须核对信号脚、2个外壳长槽及2个定位柱尺寸。
9 | 芯片、保护与连接件 | SMA母座；132289 | SMA母座；板边安装 |  | 10 | 0 | 12 | 132289 | J2 | J2 | Amphenol RF参考型号；标准SMA母针，不是RP-SMA；替代件核对焊盘及夹板厚度，当前制板要求1.50±0.05mm。
10 | 电阻 | 0Ω | 0402（英制） |  | 10 | 0 | 20 |  |  | R19;R21 | ≥0.063W。额定电流≥0.1A；AT32 R21默认装0Ω，R22默认不装。
11 | 电阻 | 100Ω 1% | 0402（英制） |  | 5 | 0 | 10 |  |  | R20 | ≥0.063W。
12 | 电阻 | 10kΩ 0.1% | 0402（英制） |  | 5 | 0 | 10 |  |  | R7 | ≥0.063W。薄膜，温漂≤25ppm/℃。
13 | 电阻 | 10kΩ 1% | 0402（英制） |  | 15 | 0 | 20 |  |  | R16;R17;R18 | ≥0.063W。
14 | 电阻 | 1MΩ 1% | 0402（英制） |  | 5 | 0 | 10 |  |  | R5 | ≥0.063W。
15 | 电阻 | 1kΩ 0.1% | 0402（英制） |  | 10 | 0 | 20 |  |  | R13;R14 | ≥0.063W。薄膜，温漂≤25ppm/℃。
16 | 电阻 | 40.2kΩ 0.1% | 0402（英制） |  | 5 | 0 | 10 |  |  | R6 | ≥0.063W。薄膜，温漂≤25ppm/℃。
17 | 电阻 | 100Ω 1% | 0603（英制） |  | 5 | 0 | 10 |  | R15 |  | ≥0.1W。
18 | 电阻 | 100kΩ 0.1% | 0603（英制） |  | 10 | 0 | 20 |  | R7;R11 |  | ≥0.1W。薄膜，温漂≤25ppm/℃。
19 | 电阻 | 10kΩ 0.1% | 0603（英制） |  | 10 | 0 | 20 |  | R13;R14 |  | ≥0.1W。薄膜，温漂≤25ppm/℃。
20 | 电阻 | 10kΩ 1% | 0603（英制） |  | 15 | 0 | 20 |  | R6;R10;R17 |  | ≥0.1W。
21 | 电阻 | 110kΩ 0.1% | 0603（英制） |  | 10 | 0 | 20 |  | R8;R12 |  | ≥0.1W。薄膜，温漂≤25ppm/℃。
22 | 电阻 | 1MΩ 1% | 0603（英制） |  | 5 | 0 | 10 |  | R5 |  | ≥0.1W。
23 | 电阻 | 1kΩ 1% | 0603（英制） | C21190 | 25 | 0 | 30 | 0603WAF1001T5E | R16;R1;R2 | R1;R2 | UNI-ROYAL厚声；含两版LED限流电阻。≥0.1W。 | https://item.szlcsc.com/21904.html
24 | 电阻 | 27.4kΩ 0.1% | 0603（英制） |  | 5 | 0 | 10 |  | R9 |  | ≥0.1W。薄膜，温漂≤25ppm/℃。
25 | 电容 | 100nF X7R 10V ±10% | 0402（英制） |  | 40 | 0 | 50 |  |  | C3;C8;C10;C11;C12;C13;C15;C17 | X7R介质，检查直流偏压降容。
26 | 电容 | 100pF C0G 50V ±5% | 0402（英制） |  | 5 | 0 | 10 |  |  | C16 | C0G/NP0介质。
27 | 电容 | 1nF C0G 50V ±5% | 0402（英制） |  | 5 | 0 | 10 |  |  | C9 | C0G/NP0介质。
28 | 电容 | 1µF X7R 10V ±10% | 0402（英制） |  | 5 | 0 | 10 |  |  | C14 | X7R介质，检查直流偏压降容。
29 | 电容 | 100nF X7R 10V ±10% | 0603（英制） |  | 10 | 0 | 20 |  | C3;C8 |  | X7R介质，检查直流偏压降容。
30 | 电容 | 1nF C0G 50V ±5% | 0603（英制） |  | 5 | 0 | 10 |  | C9 |  | C0G/NP0介质。
31 | 电容 | 1µF X7R 10V ±10% | 0603（英制） |  | 10 | 0 | 20 |  | C1 | C1 | X7R介质，检查直流偏压降容。
32 | 电容 | 4.7µF X7R 10V ±10% | 0603（英制） |  | 15 | 0 | 20 |  | C2;C7 | C2 | X7R介质，检查直流偏压降容。
33 | 电容 | 470pF C0G 50V ±5% | 0603（英制） |  | 10 | 0 | 20 |  | C5;C6 |  | C0G/NP0介质。
34 | 电容 | 10µF X7R 10V ±10% | 0805（英制） |  | 5 | 0 | 10 |  |  | C7 | X7R介质，检查直流偏压降容。
35 | 电容 | 33nF C0G 50V ±5% | 0805（英制） |  | 10 | 0 | 12 | C2012C0G1H333J125AA | C4 | C4 | C0G/NP0介质。TDK参考型号；33nF，不是33pF或3.3nF；不得直接改用X7R。
36 | 已有LED | 蓝色LED；Vf 2.5–3V | 0603（英制） |  | 20 | 20 | 0 |  | LED1;LED2 | LED1;LED2 | 用户已有200多颗，本次从库存取20颗；PWR及RUN同色；焊接前确认阴极。
