pulsefoundry/Aster-MCA-Nano/outputs/Aster-MCA-Nano-CH32-v0.3-USB-A-LED/testpoints.csv

Designator | Signal | X_mm_from_left_top_view | Y_mm_from_top_top_view | Copper_side
TP1 | GND | 11.0 | 13.5 | BOTTOM
TP2 | V3V3 | 13.5 | 13.5 | BOTTOM
TP3 | SDI_DIO | 16.0 | 13.5 | BOTTOM
TP4 | SDI_CLK | 18.5 | 13.5 | BOTTOM
TP5 | NRST | 11.0 | 16.0 | BOTTOM
TP6 | VMID | 13.5 | 16.0 | BOTTOM
TP7 | OPA2_OUT | 16.0 | 16.0 | BOTTOM
TP8 | ADC_IN | 18.5 | 16.0 | BOTTOM
