pulsefoundry/Aster-MCA-Nano/outputs/Aster-MCA-Nano-AT32-v0.3-USB-A-LED/assembly-top.png

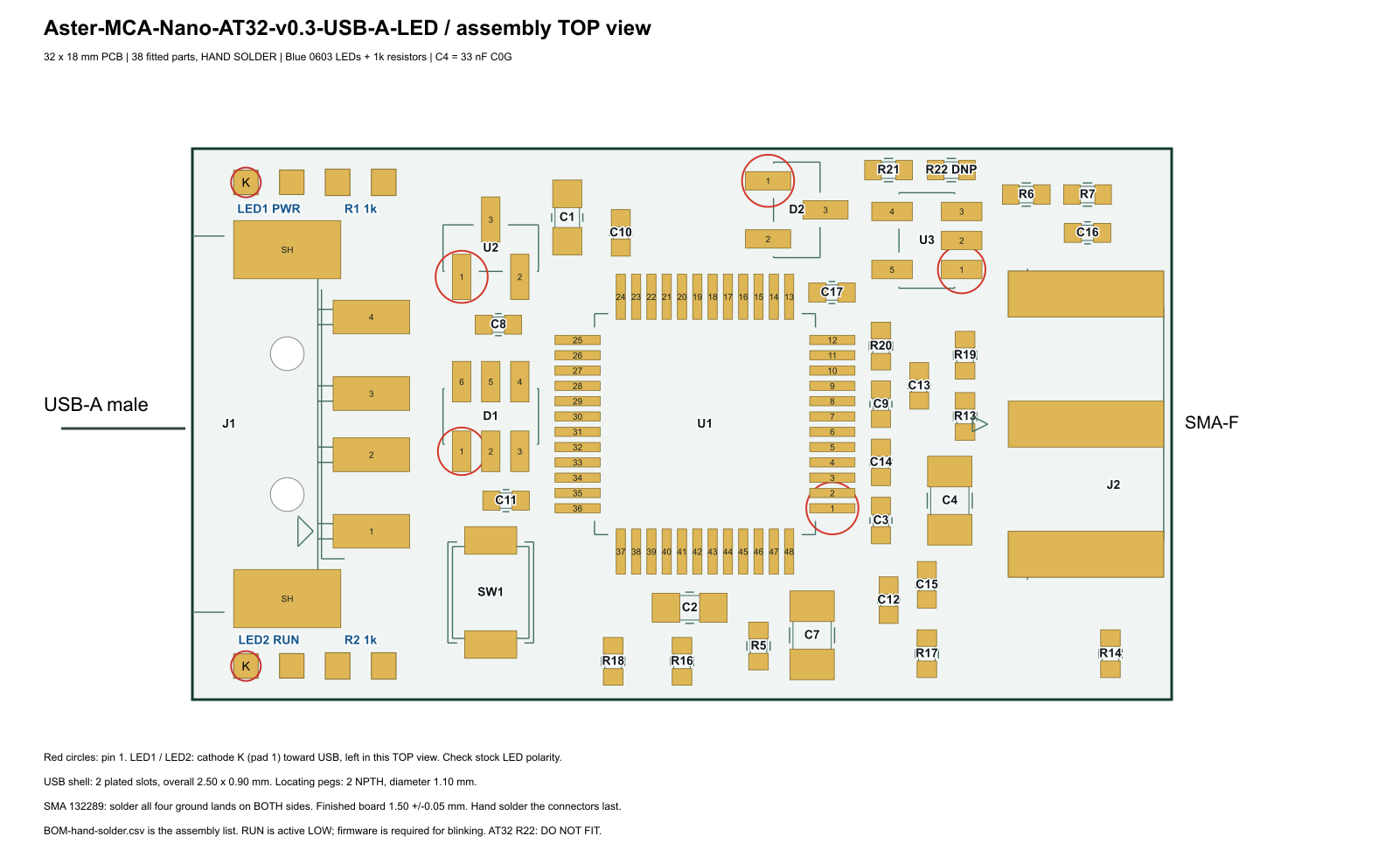
outputs/Aster-MCA-Nano-AT32-v0.3-USB-A-LED/assembly-top.png
