pulsefoundry/Aster-MCA-Nano/firmware/at32-bringup/README.txt

2026-10-14 13:04 解锁并允许 USB 后的追加验证（最新状态）

结论：USB CDC 命令收发、ADC 原始数据读取、ADC 暂停/重新初始化测试通过。
用户确认运行灯闪烁。macOS 已开放数据接口，上一阶段的配件访问阻塞已解除。
本轮未改写固件；仍为 v0.1.0。

验证结果
- 设备：Aster MCA Nano AT32，USB 2E3C:5740，序列号 13819F0C2876。
- 串口：/dev/cu.usbmodem13819F0C28761。
- INFO/PING 成功；ADC 初始化故障码为 0，xtest=9。
- 7 组 × 4096 = 28672 点，所有 RAW 帧的 CRC32、最小值、最大值、总和、平方和
  均由主机独立重算并与固件返回值一致。
- 关闭 ADC 后拒绝采样，重新初始化后采样正常；最后保持 SLOW 配置，ADC 开启。
- 心跳翻转计数从 954 增长至 958；实物灯闪烁由用户确认。

前三组慢速配置（名义 10 kS/s，采样时间 640.5 ADC 周期）
- 合并均值：2046.9453 码，约 1.649150 V。
- 合并标准差：2.2769 LSB，约 1.8344 mV RMS。
- 样本范围：2037–2056 码。
- 内部计数器测得触发间距：97.6458–102.3333 us。

三组快速配置（名义 100 kS/s，采样时间 47.5 ADC 周期）
- 合并均值：2049.6757 码，约 1.651350 V。
- 合并标准差：2.1589 LSB，约 1.7394 mV RMS。
- 样本范围：2040–2058 码。
- 内部计数器测得触发间距：9.1667–12.4792 us。

适用范围与后续
- 电压均按名义 VDDA=3.3 V、4096 码换算，指 ADC 引脚处，未做绝对电压标定。
- 噪声值是当前板级输入链路+ADC 的短记录标准差，不能当成芯片自身 ENOB 或最终能量分辨率。
- 两种配置均值差约 2.200 mV；采样率和采样时间同时变化，
  本轮不能单独归因为某一硬件因素。重复性、幅度线性、削顶和窄脉冲响应待接入已知信号检查。
- SMA 按先前指示保持悬空，用户本轮没有重新报告接线状态；如实际接有信号源，需重新标注此记录条件。
- 当前是软件定时采样，存在触发间隔抖动；名义采样率与间距换算基于内部 48 MHz 时钟，未外部校准。
- 尚未验证连续 DMA 采样、真实核脉冲、寻峰及能谱；没有因这组数据要求拆除 AT32 的 C9。

原始数据与完整响应：baseline-after-allow-01/result.json、各组 .bin/.json 和 summary.json。

============================================================
以下为首次烧录时的历史记录；其中 USB 访问限制已由上述追加验证解除。
============================================================

Aster MCA Nano AT32 v0.3 — 首次烧录记录
记录时间：2026-10-14T13:00:19.441401+08:00

结论：测试固件 v0.1.0 已写入，读回逐字节校验通过，程序已开始 USB 枚举。
ADC 基线、完整 USB 命令收发、运行灯实物观察尚未完成，不能据此认定 MCA 功能通过。

实物与前提
- 板型：Aster MCA Nano AT32 v0.3 USB-A LED。
- 主控按用户确认型号 AT32F423CCT7 构建；DFU 实际报告 256 KiB Flash、2 KiB 擦除页。
- 用户报告 3V、VA、M、AD 的静态电压均符合预期，未提供本轮精确数值。
- 本轮测试要求 SMA 悬空；没有远程确认实际接线的能力。
- AT32 外置 TLV9061；没有要求用户拆除 AT32 的 C9。

已完成并留有记录
1. 烧录前备份 Flash 262144 字节（全为 0xFF）和选项字节 512 字节。
2. 在 0x08000000 写入 14476 字节。
3. 读回整片 256 KiB，固件范围逐字节相同，其余 Flash 与原备份相同。
4. 选项字节前后完全相同。
5. 退出 DFU 后，Mac 读取到设备名称 Aster MCA Nano AT32，USB ID 2E3C:5740。
   退出命令返回 GETSTATUS 的 LIBUSB_ERROR_IO/退出码 74；随后成功出现应用 USB 身份，
   因此不能将这个断开期间的返回值当作固件校验失败。没有重新擦写。

尚未完成的验证与阻塞
- macOS IOUSBHostDevice 显示 !registered、!matched，尚未生成 USB 串口。
- 系统日志在 12:56:32 显示 transportRestricted: NO -> YES，
  并对该 Aster 设备记录 device will not be registered for matching。
- 用户暂时离开；电脑界面读取工具也超时，无法现场处理配件提示。
- 因此没有读到 PING/INFO/STATS/RAW；没有 ADC 均值、噪声或采样完整性实测结果。
- 运行灯代码为 PB12 每 500 ms 翻转（每秒一个明暗周期），实物闪烁待观察。

固件范围
- 无外部晶振，HICK 48 MHz + ACC；ADC 时钟 12 MHz。
- PA0 / ADC1_IN0，PB12 低电平点亮 RUN；PA9 保持输入；保留 SWD。
- ADC 初始化含 ES0010 的 xtest=9 修正。
- SLOW：名义 10 kS/s，640.5 周期采样；FAST：名义 100 kS/s，47.5 周期采样。
- 每块 4096 个 12 位样本。软件定时轮询，保持 USB 中断，并报告实际触发间距。
- 这是上电诊断固件；没有 DMA 连续采集、核脉冲寻峰、能量标定或能谱输出。
- ADC 初始化开启，但只有收到 STATS/RAW 才采样。

回来后的操作
1. 解锁 Mac，若弹出该板的配件访问提示，点允许。无需再按 BOOT。
2. 保持 SMA 悬空，观察 RUN 灯是否每秒闪一轮。
3. 接口开放后运行 source/read_baseline.py；它将读取并校验 3 组慢速、3 组快速样本，
   检查 ADC 暂停/重启，再留在慢速配置。不要在未知接线条件下把记录称为静态基线。
   示例（PORT 替换为实际 /dev/cu.usbmodem...，OUTPUT 为不存在的新目录）：
   python3 source/read_baseline.py --port PORT --output OUTPUT
4. 若需再次烧录，保持 SMA 断开，按住 BOOT 重插 USB 进入工厂 DFU。

固件来源与重建
- 项目源码：firmware/at32-bringup/main.c，构建脚本 build.py。
- 官方 SDK commit：a60472b248c39034f111ac17e7b1286549594435。
  https://github.com/ArteryTek/AT32F423_Firmware_Library
- 当前构建脚本依赖原项目 work/at32-bringup-2026-10-14/sdk 和本机 ARM GNU 14.2 工具链。
  source/ 是源码快照，不是含工具链/SDK 的独立重建包；重建请在原工程运行 build.py。
- USB VID/PID 沿用厂商 CDC 示例，仅用于当前原型验证。
- 本记录不会修改 PCB/BOM；不会把 CH32 板的 C9 现象当作 AT32 已证实的问题。
