pulsefoundry/Aster-MCA-Nano/docs/repository-validation-2026-10-18.md

# 源码归档检查：2026-10-18

在仅包含拟提交文件的干净导出副本中执行，未访问实体板子。

- 取峰／短波形算法与协议：21 项中 20 项通过；1 项大体积历史波形重放因本机 `work` 数据未随仓库分发而明确跳过。
- 上位机／通信／导出：21 项全部通过。
- 当前固件使用原实验的完整 ARM GNU Toolchain 14.2.Rel1 及固定版本 AT32 SDK 重编译，24004 字节，与已烧录验证的 v0.8.2 镜像逐字节一致。
- 固件 SHA256：`40bdc400d1342128eccd6fee780109b5912d556745b524498abc322755162dea`。
- 源码支持 `ARM_GCC_BIN`、`AT32_SDK`、`DFU_UTIL` 指定依赖位置。编译器须包含新库及标准 C 头文件，单独的 GCC 程序不足以链接固件。
- 原生桌面软件在干净副本中重新打包、签名校验及打包后端自检通过；未启动该测试副本或连接板子。
- 使用仓库内归档谱，复现改焊前后各 60 秒的拟合结果：17.19655%／16.07075%。
- 使用仓库内改焊后铯源 RAW 重放，得到 162 个候选、135 个接受事件；逐段直方图与整数 MCU 算法完全匹配。
- 3 份历史 SHA256 清单中共 151 个文件校验通过。清单同时兼容纯 SHA 字符串和包含字节数／SHA 的对象两种格式，未修改原始实验数据及冻结清单。
- Git 记录包含源码、命名的制板资料及实测证据。工具链、完整 AT32 SDK、虚拟环境、本机临时记录和打包应用运行时保留在本机忽略目录。

复核归档：`python3 scripts/verify_artifacts.py`。其它复现命令见根目录 README。
