pulsefoundry/Aster-MCA-Nano/outputs/Aster-MCA-Nano-AT32-v0.3-USB-A-LED/Aster-MCA-Nano-AT32-v0.3-USB-A-LED-Schematic.pdf

# 01 MCU and analog pulse input | ENGINEERING PROTOTYPE - performance unverified

## 132289 SMA-F

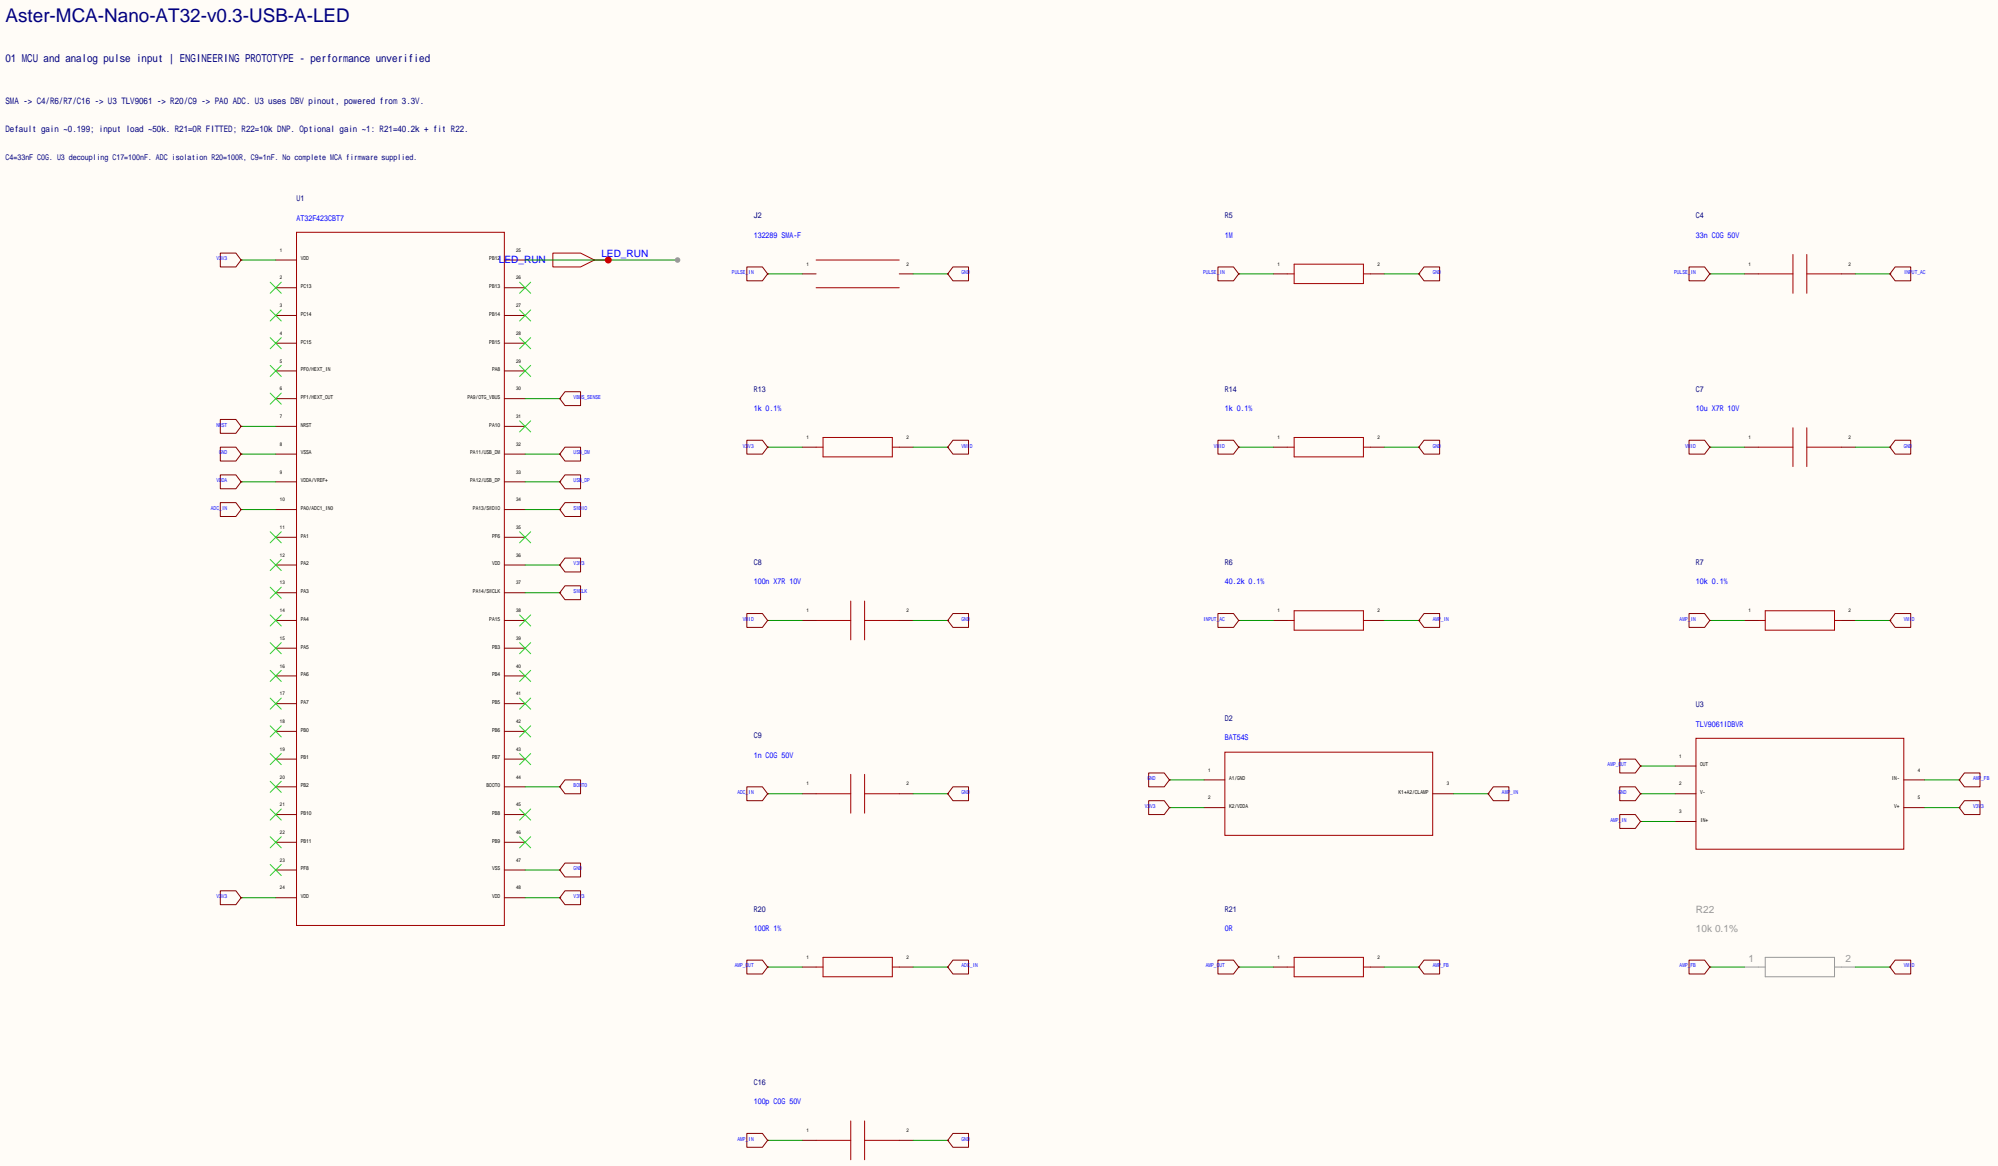
[picture p25: page 1]

Aster-MCA-Nano-AT32-v0.3-USB-A-LED

SMA -> C4/R6/R7/C16 -> U3 TLV9061 -> R20/C9 -> PA0 ADC. U3 uses DBV pinout, powered from 3.3V.

Default gain ~0.199; input load ~50k. R21=0R FITTED; R22=10k DNP. Optional gain ~1: R21=40.2k + fit R22.

C4=33nF C0G. U3 decoupling C17=100nF. ADC isolation R20=100R, C9=1nF. No complete MCA firmware supplied.

# Aster-MCA-Nano-AT32-v0.3-USB-A-LED

# 02 USB-A, power and boot | ENGINEERING PROTOTYPE - performance unverified

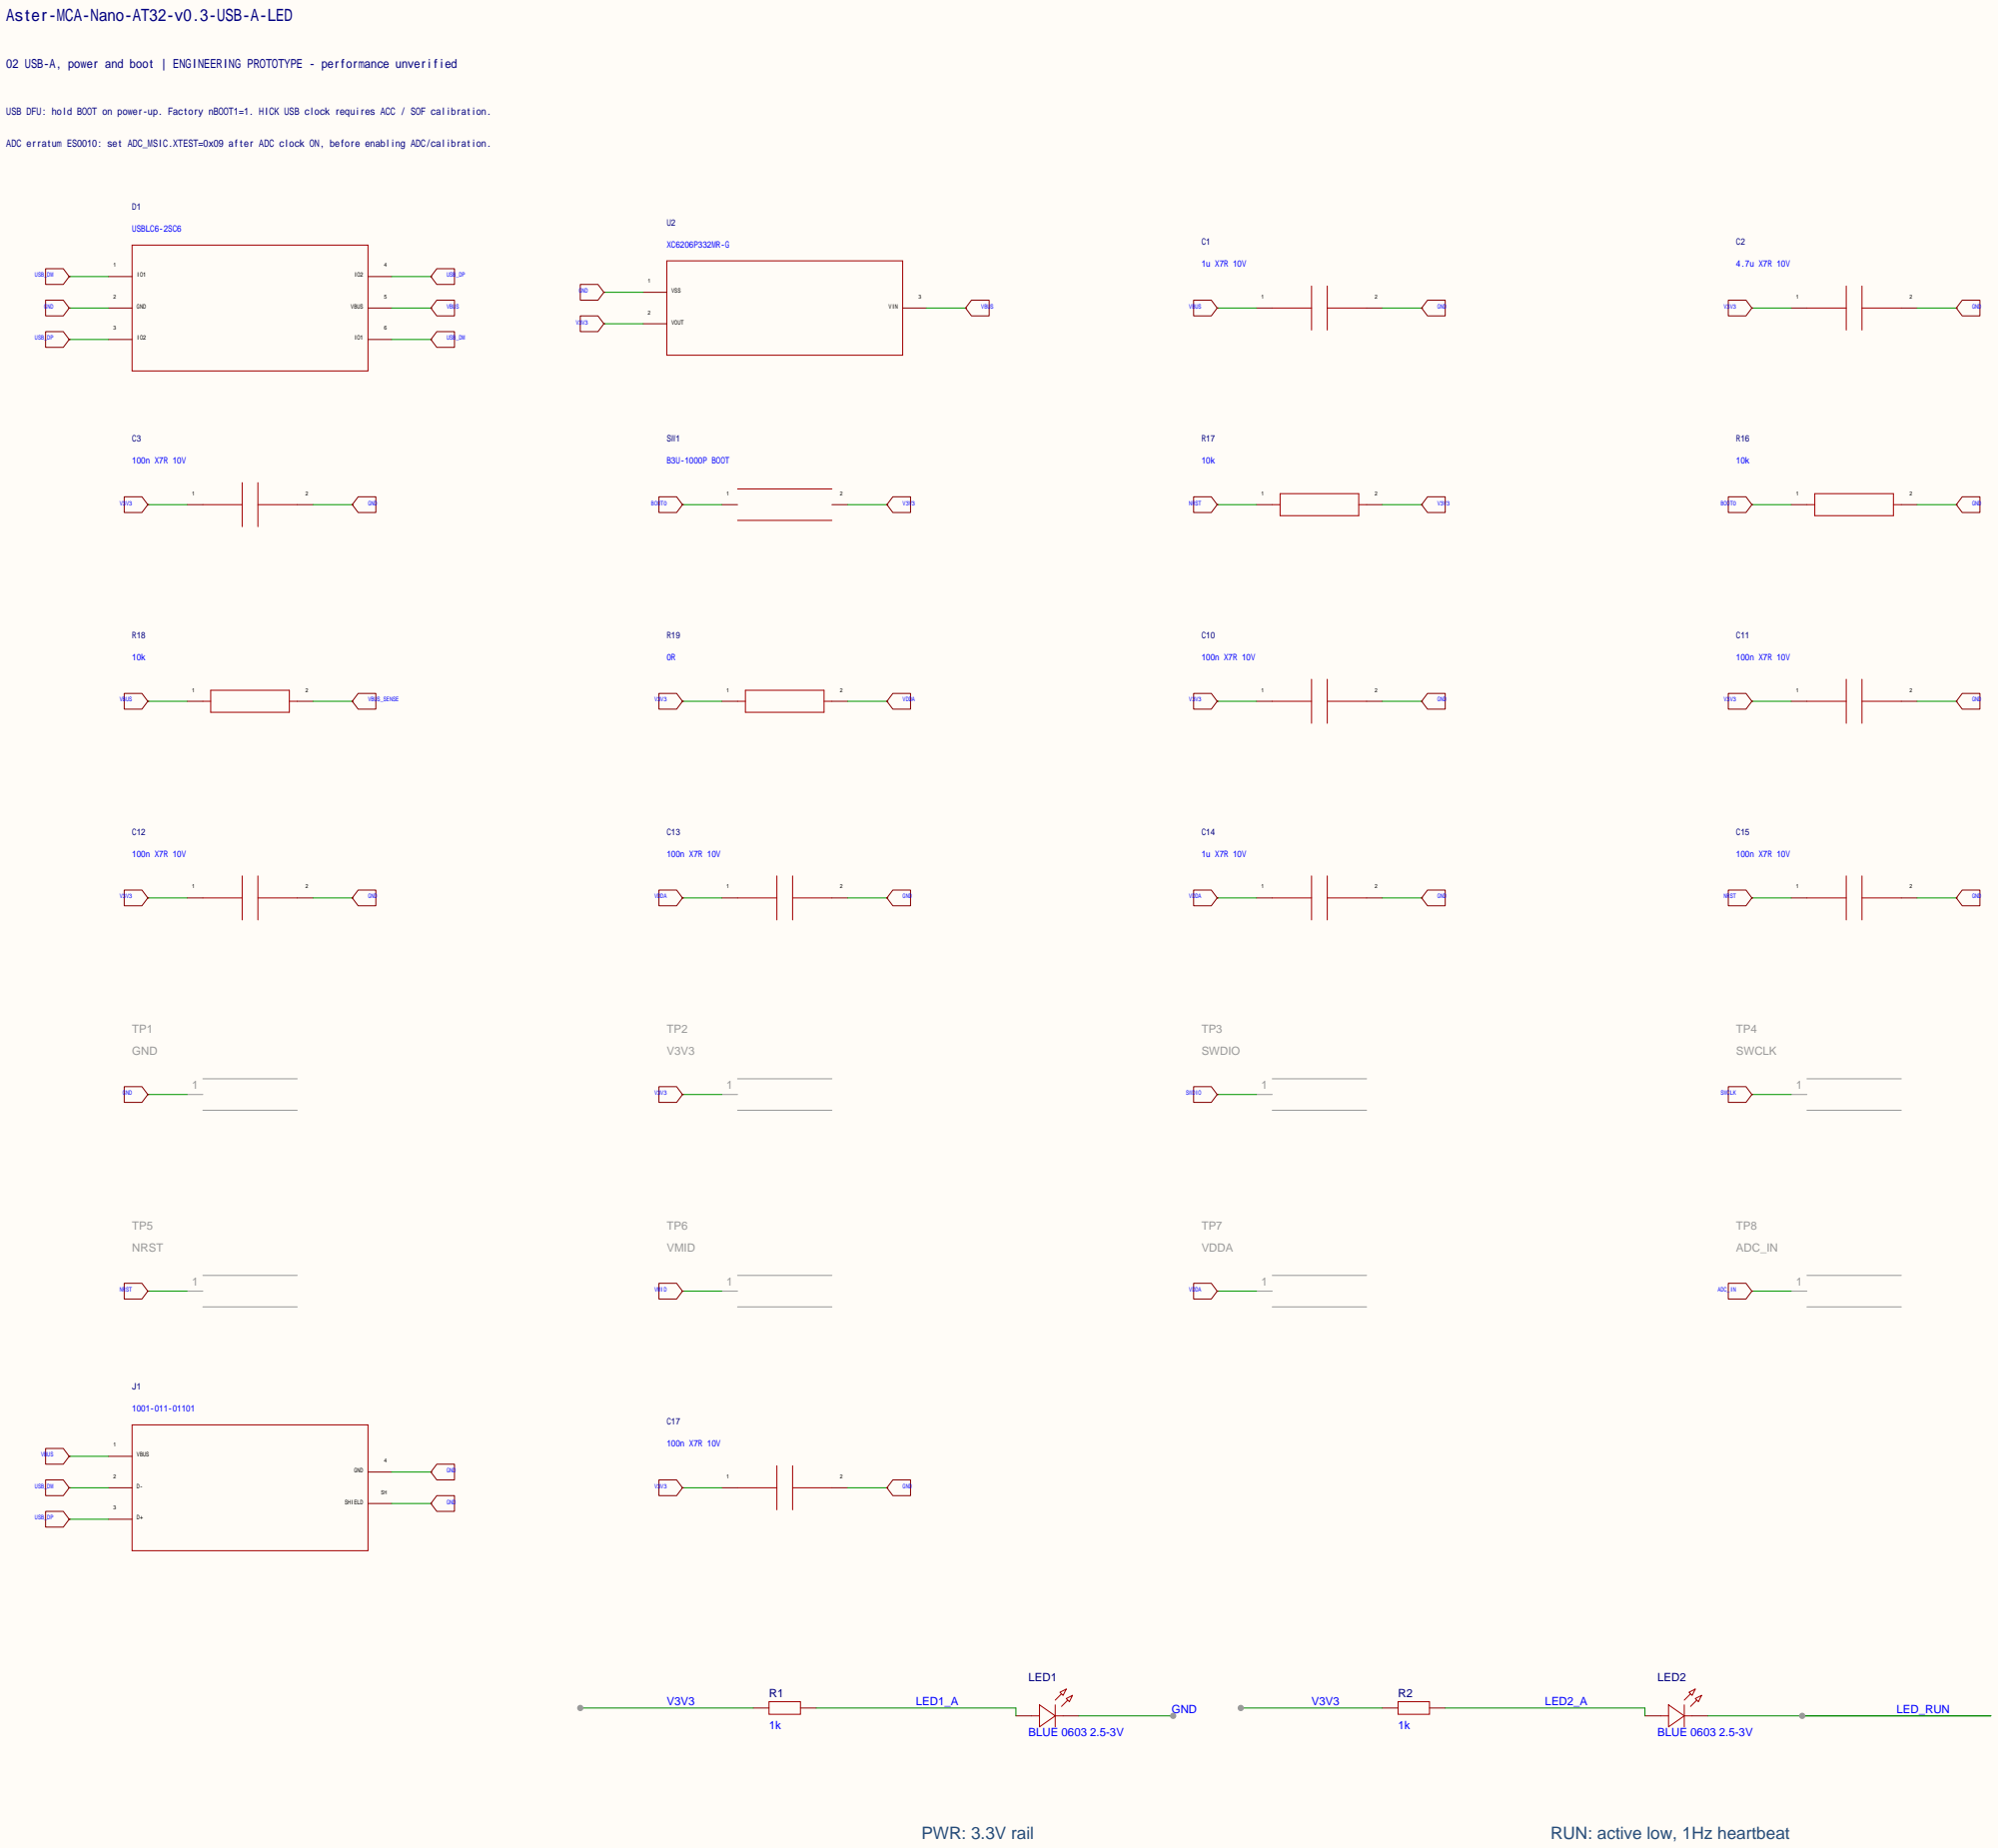
[picture p26: page 2]

USB DFU: hold BOOT on power-up. Factory nBOOT1=1. HICK USB clock requires ACC / SOF calibration.

ADC erratum ES0010: set ADC_MSIC.XTEST=0x09 after ADC clock ON, before enabling ADC/calibration.

RUN: active low, 1Hz heartbeat
