pulsefoundry/Aster-MCA-Nano/outputs/Aster-MCA-Nano-CH32-v0.3-USB-A-LED/Aster-MCA-Nano-CH32-v0.3-USB-A-LED-Schematic.pdf

# Aster-MCA-Nano-CH32-v0.3-USB-A-LED

# 01 MCU and analog pulse input | ENGINEERING PROTOTYPE - performance unverified

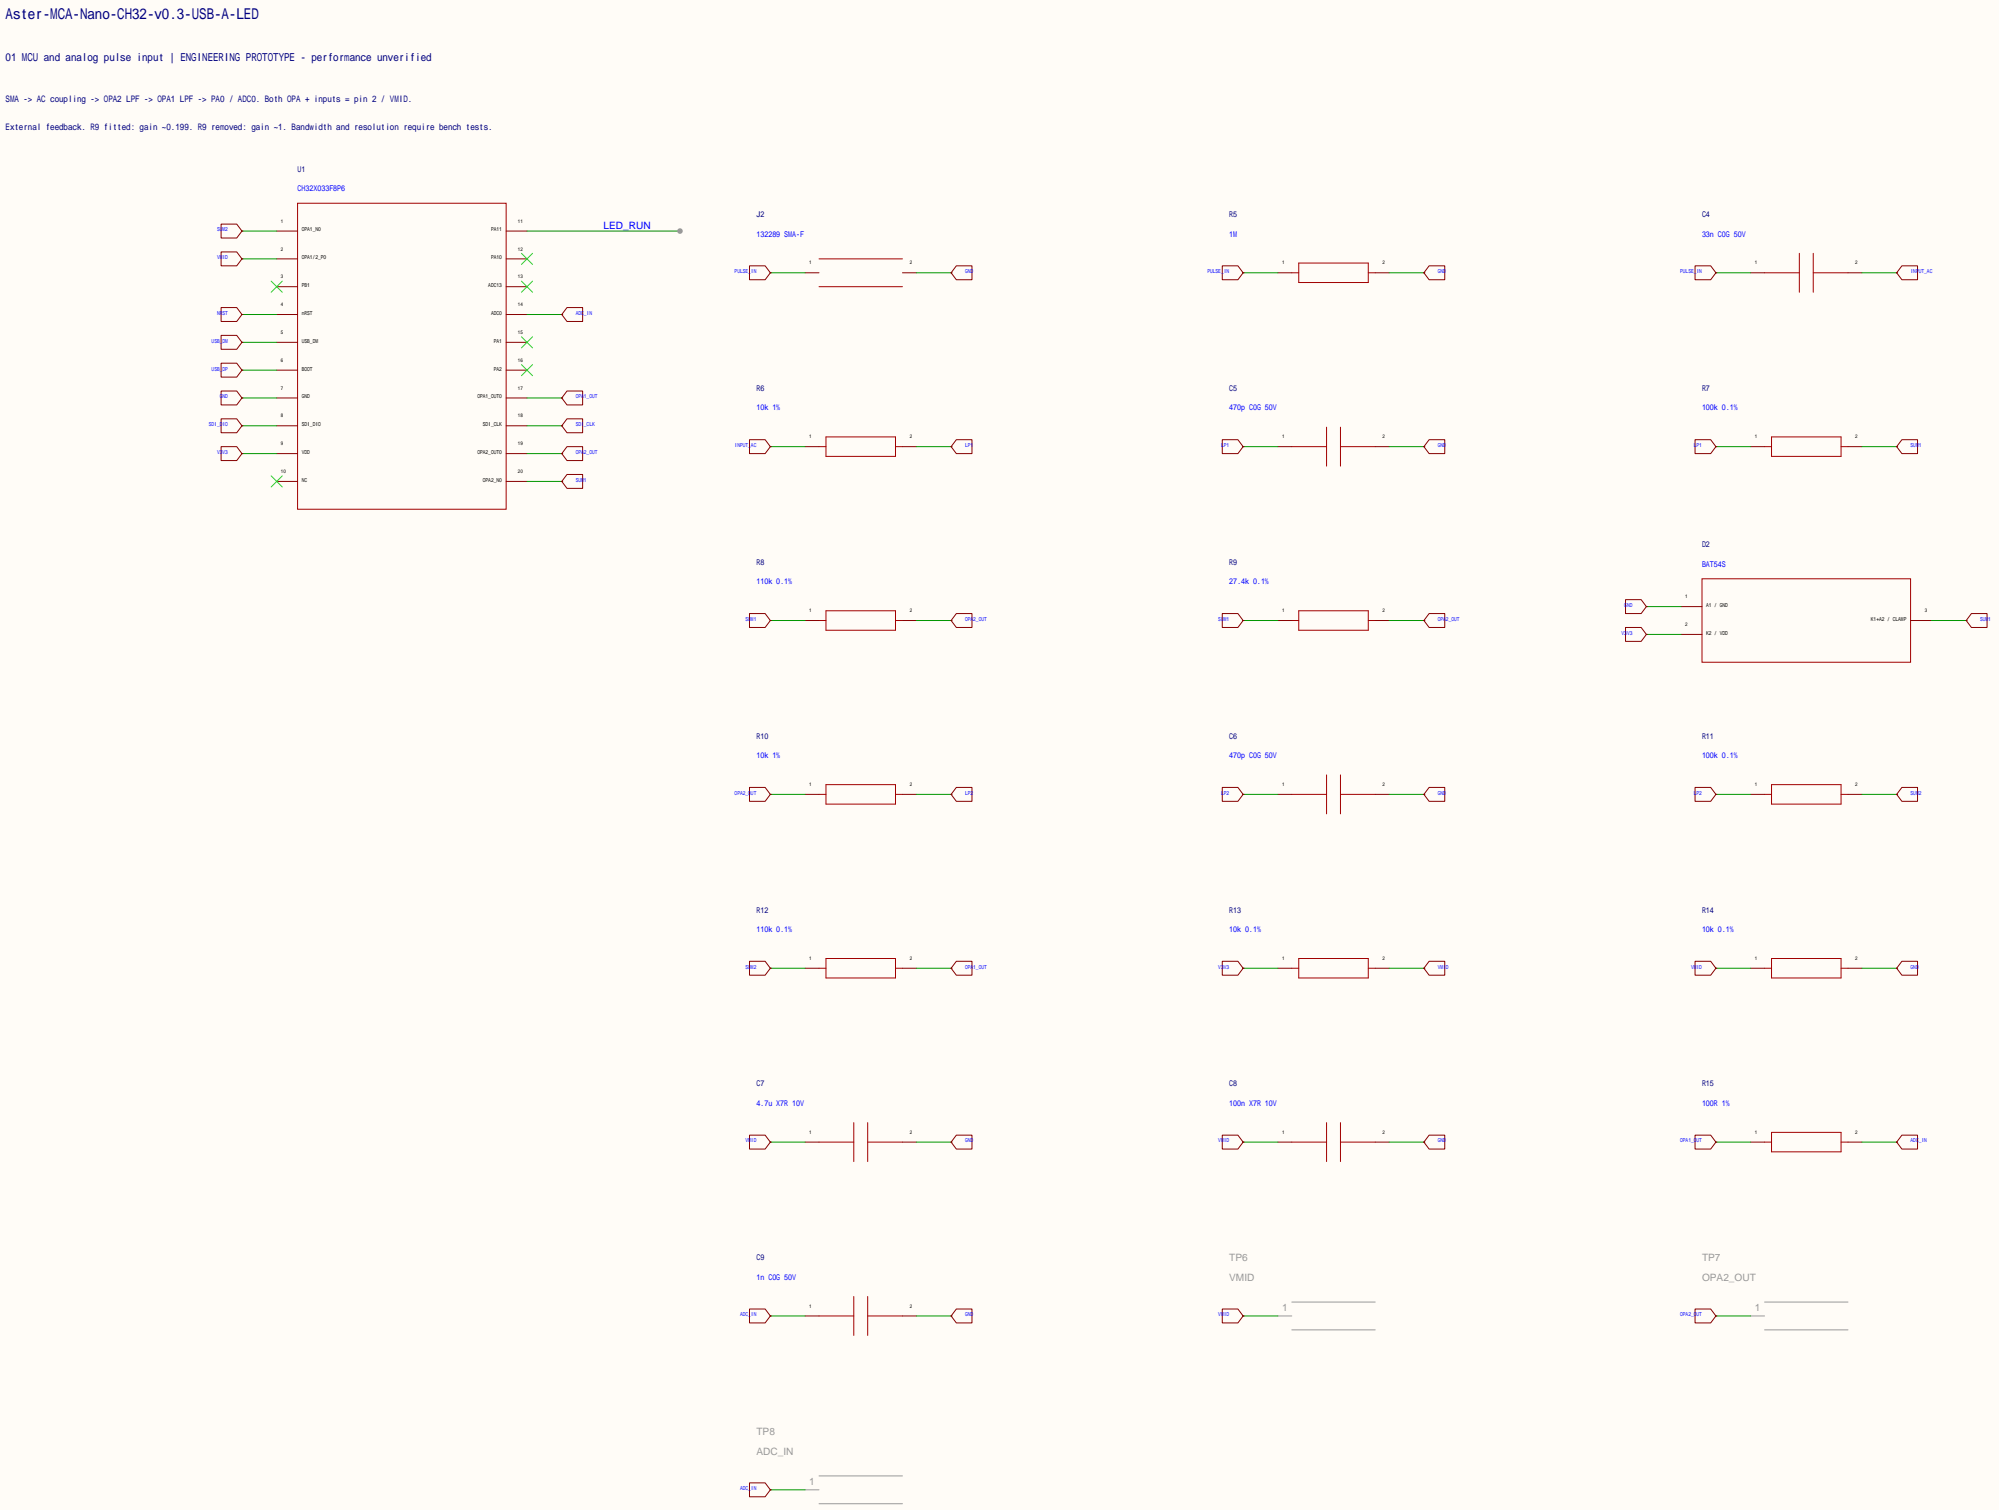
[picture p27: page 1]

SMA -> AC coupling -> OPA2 LPF -> OPA1 LPF -> PA0 / ADC0. Both OPA + inputs = pin 2 / VMID.

External feedback. R9 fitted: gain ~0.199. R9 removed: gain ~1. Bandwidth and resolution require bench tests.

# Aster-MCA-Nano-CH32-v0.3-USB-A-LED

# 02 USB-A, power and boot | ENGINEERING PROTOTYPE - performance unverified

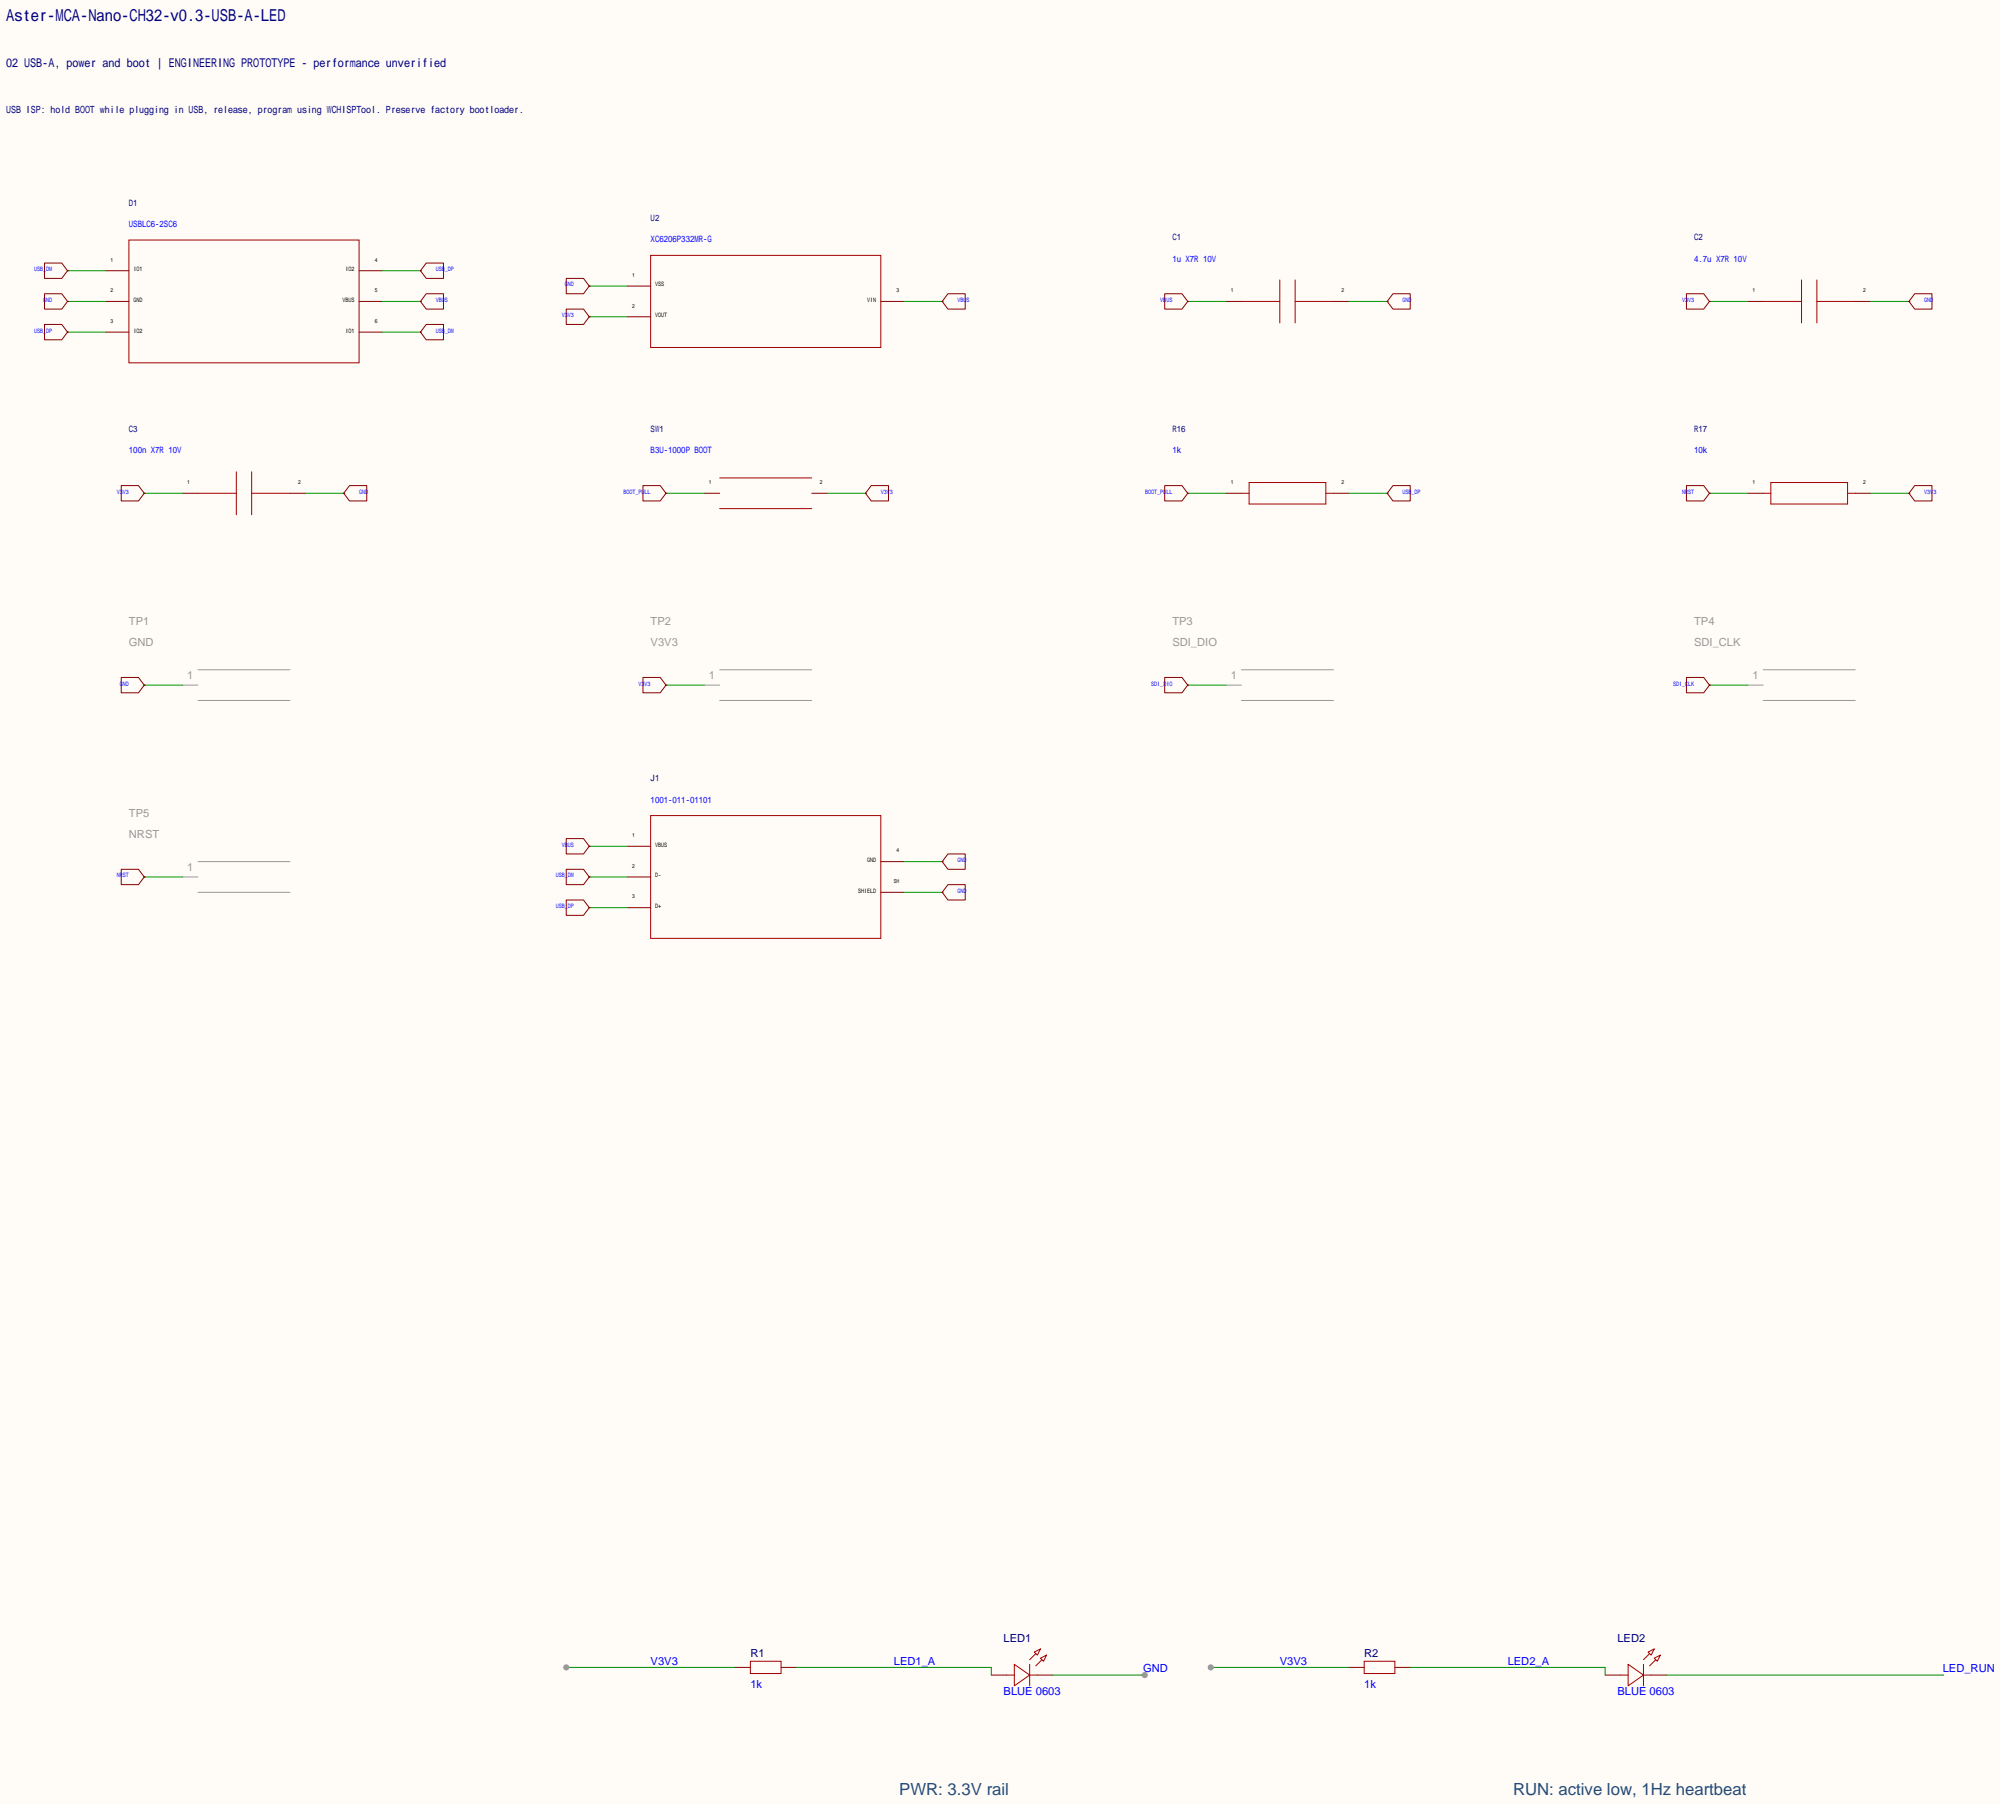
[picture p28: page 2]

USB ISP: hold BOOT while plugging in USB, release, program using WCHISPTool. Preserve factory bootloader.

RUN: active low, 1Hz heartbeat
