pulsefoundry/Aster-MCA-Nano/firmware/ch32-selftest-v0.3/src/ch32x035_conf.h

#ifndef ASTER_CONF_H
#define ASTER_CONF_H
#include "ch32x035_rcc.h"
#include "ch32x035_gpio.h"
#include "ch32x035_adc.h"
#include "ch32x035_dma.h"
#include "ch32x035_opa.h"
#include "ch32x035_pwr.h"
#endif
