pulsefoundry/Aster-MCA-Nano/docs/at32/photos/IMG_1201.JPG

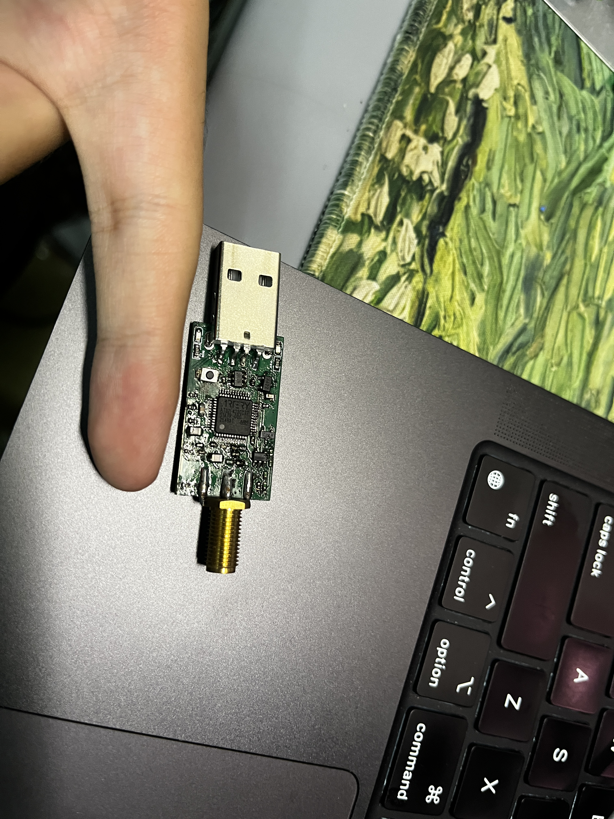
[picture p1: docs/at32/photos/IMG_1201.JPG]
docs/at32/photos/IMG_1201.JPG
