pulsefoundry/Aster-MCA-Nano/docs/at32/photos/IMG_1202.JPG

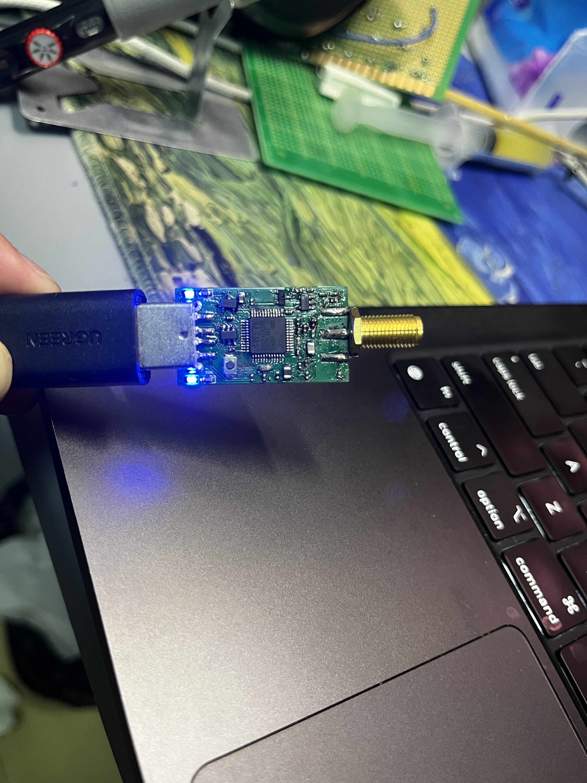
[picture p2: docs/at32/photos/IMG_1202.JPG]
docs/at32/photos/IMG_1202.JPG
